promaaa/vision-sobang/sim/rl/runs/off_ss_stage1/sim2sim.md

| Model | Test | Official: result | Official: vx / yaw rate | Ours: result | Ours: vx / yaw rate |
|---|---|---|---|---|---|
| bhl_A_real | stand | no fall | +0.00 / -0.00 | no fall | +0.00 / -0.00 |
| bhl_A_real | vx 0.1 | no fall | +0.00 / -0.00 | no fall | -0.00 / -0.00 |
| bhl_A_real | vx 0.25 | no fall | +0.23 / -0.05 | no fall | -0.00 / +0.00 |
| bhl_A_real | turn on the spot 0.5 | no fall | +0.00 / +0.04 | no fall | -0.00 / +0.01 |
| bhl_A_real | vx 0.25 + yaw 0.5 | no fall | +0.23 / +0.48 | no fall | -0.00 / +0.01 |
| bhl_A_real | push test, stand | falls in 7 of 10 runs | - | falls in 10 of 10 runs | - |
| bhl_A_real | push test, vx 0.25 | falls in 5 of 10 runs | - | falls in 6 of 10 runs | - |
| bhl_A_real | push test, turn on the spot 0.5 | falls in 6 of 10 runs | - | falls in 9 of 10 runs | - |
| bhl_B_real | stand | no fall | +0.00 / -0.00 | falls at 1.1 s | - |
| bhl_B_real | vx 0.1 | no fall | +0.00 / -0.00 | falls at 3.1 s | - |
| bhl_B_real | vx 0.25 | no fall | +0.11 / -0.04 | no fall | -0.00 / -0.00 |
| bhl_B_real | turn on the spot 0.5 | no fall | +0.00 / +0.01 | falls at 1.2 s | - |
| bhl_B_real | vx 0.25 + yaw 0.5 | no fall | +0.14 / +0.46 | no fall | -0.00 / +0.01 |
| bhl_B_real | push test, stand | falls in 10 of 10 runs | - | falls in 10 of 10 runs | - |
| bhl_B_real | push test, vx 0.25 | falls in 7 of 10 runs | - | falls in 8 of 10 runs | - |
| bhl_B_real | push test, turn on the spot 0.5 | falls in 9 of 10 runs | - | falls in 10 of 10 runs | - |
