promaaa/vision-sobang/cad/backpack/renders/front.png

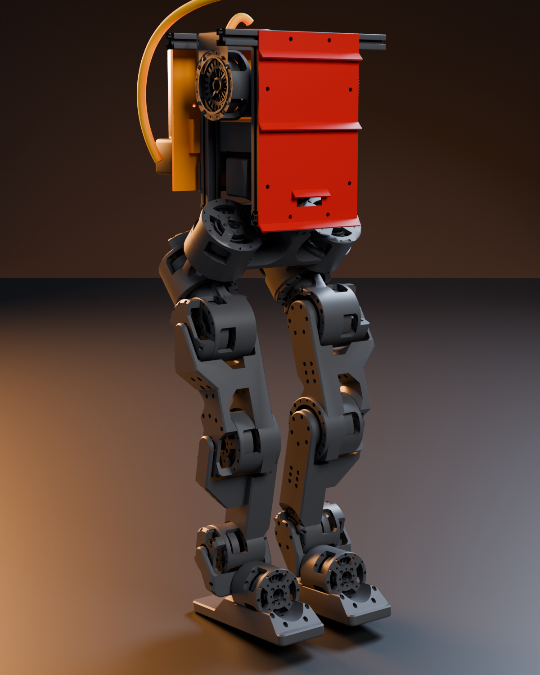
cad/backpack/renders/front.png
