promaaa/vision-sobang/cad/backpack/renders/rear.png

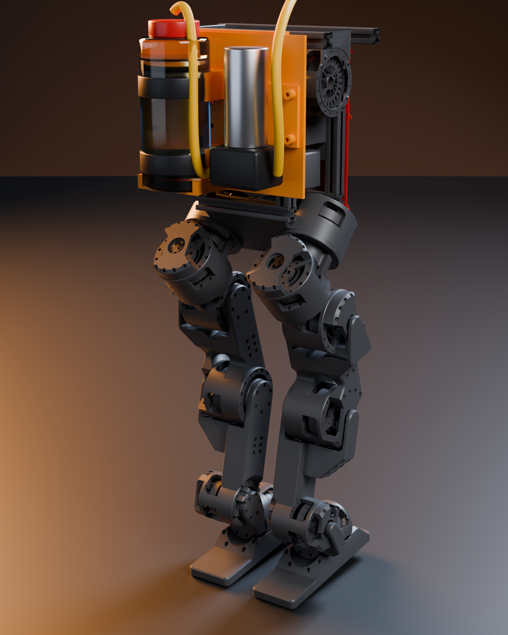
cad/backpack/renders/rear.png
