promaaa/vision-sobang/cad/backpack/renders/rear_detail.png

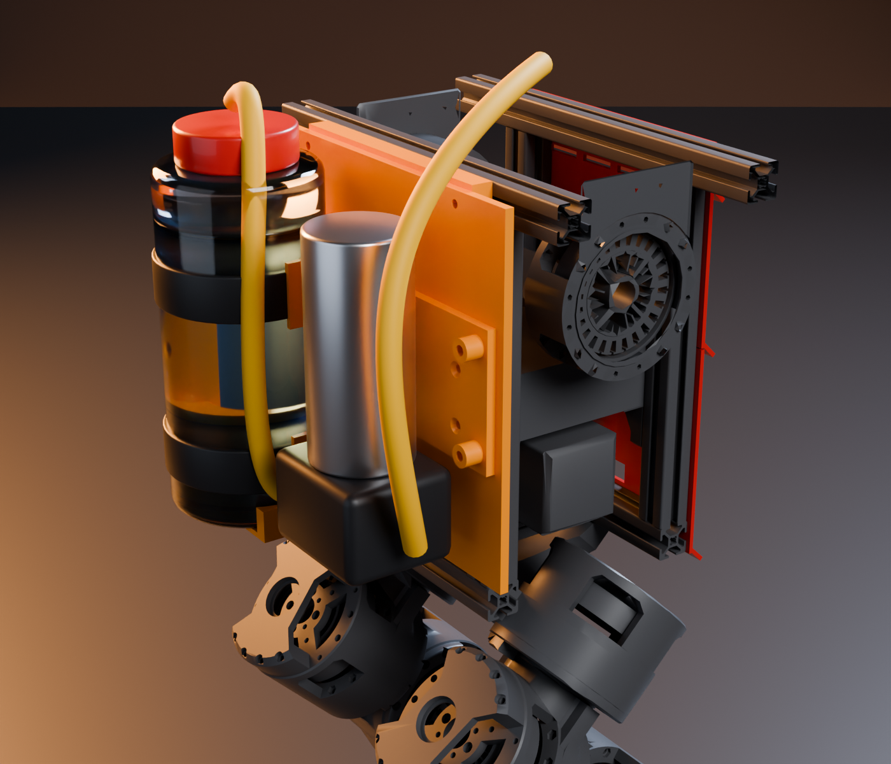
cad/backpack/renders/rear_detail.png
