promaaa/vision-sobang/cad/camera_views/out/overview_A.jpg

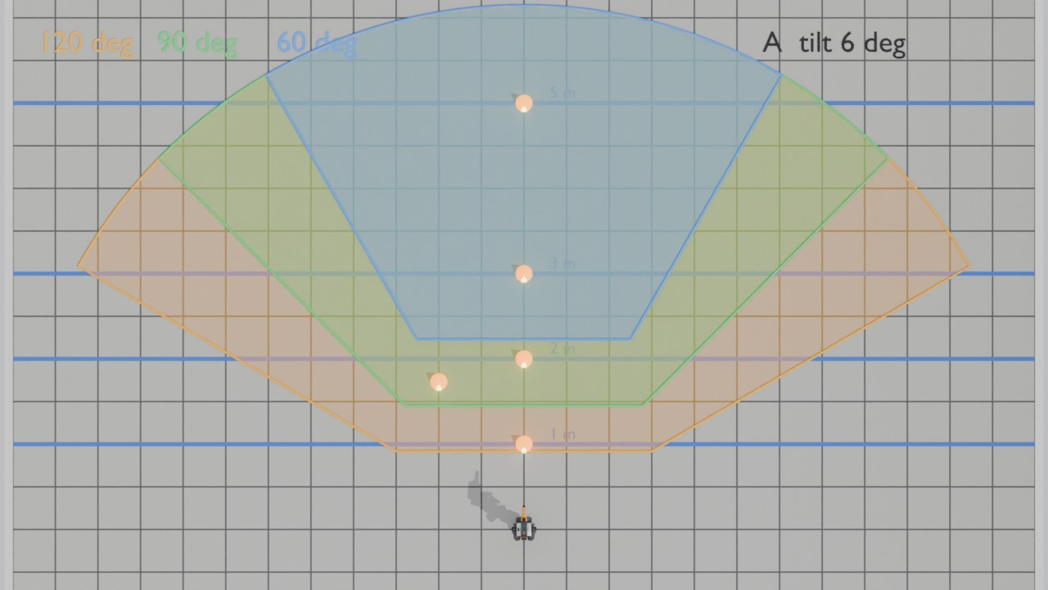
cad/camera_views/out/overview_A.jpg
