promaaa/vision-sobang/cad/camera_views/out/round2/A_1_before.jpg

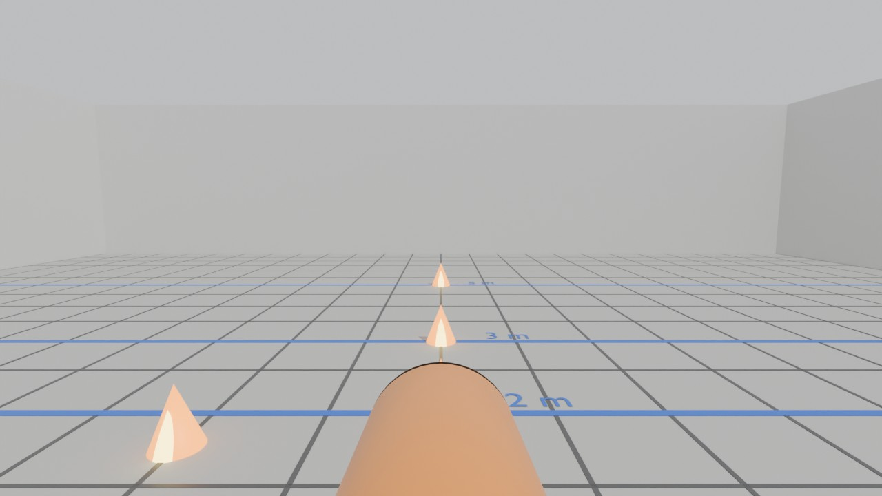
cad/camera_views/out/round2/A_1_before.jpg
