promaaa/vision-sobang/cad/camera_views/out/round2/A_2_after_camera.jpg

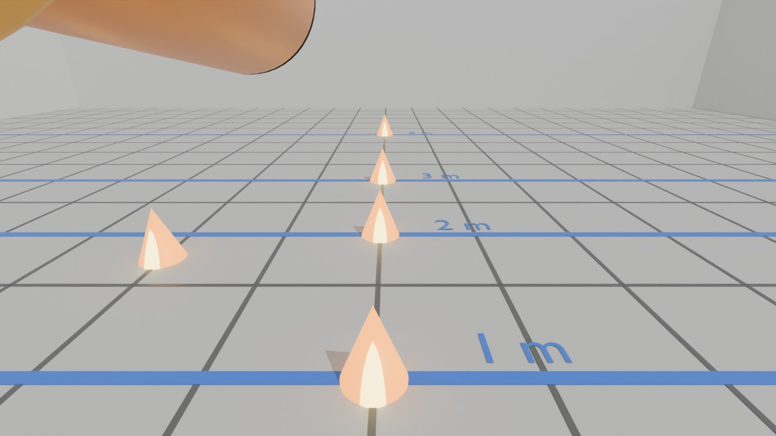
cad/camera_views/out/round2/A_2_after_camera.jpg
