promaaa/vision-sobang/cad/camera_views/out/round2/B_1_before.jpg

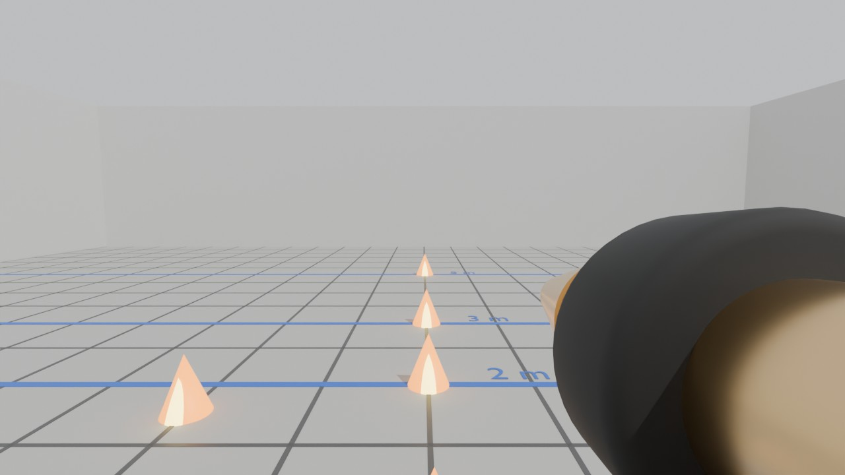
cad/camera_views/out/round2/B_1_before.jpg
