promaaa/vision-sobang/cad/camera_views/out/round2/B_3_after_nozzle.jpg

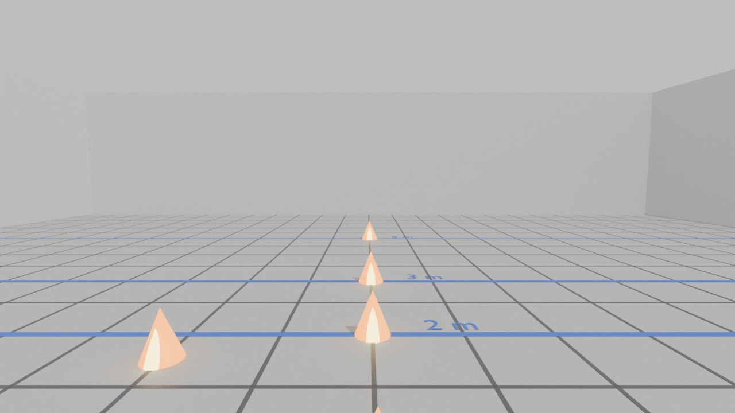
cad/camera_views/out/round2/B_3_after_nozzle.jpg
