promaaa/vision-sobang/cad/camera_views/out/views/A_tilt06_hfov060.jpg

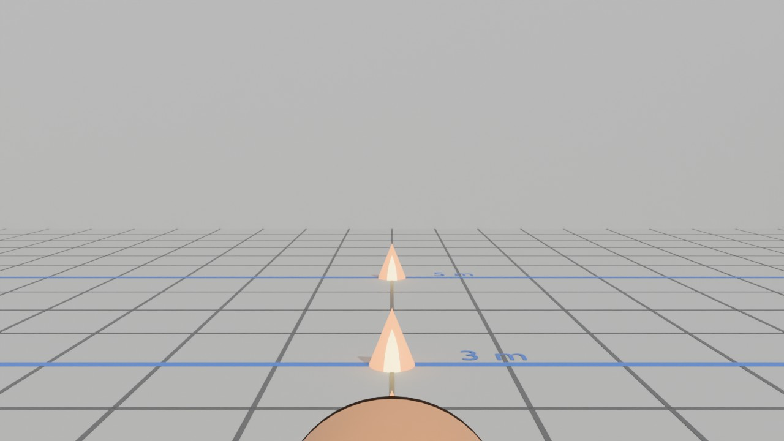
cad/camera_views/out/views/A_tilt06_hfov060.jpg
