promaaa/vision-sobang/cad/camera_views/out/views/A_tilt20_hfov060.jpg

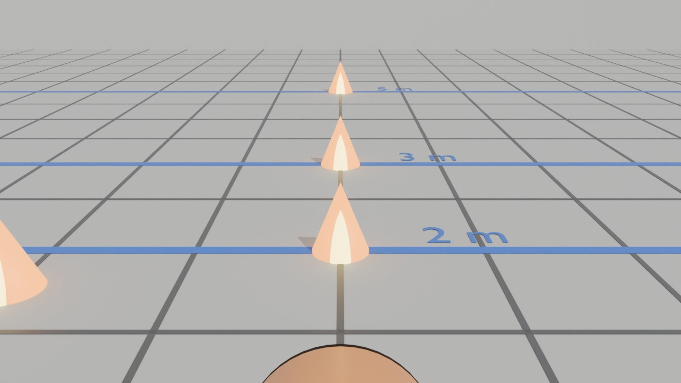
cad/camera_views/out/views/A_tilt20_hfov060.jpg
