promaaa/vision-sobang/cad/camera_views/out/views/B_tilt05_hfov120.jpg

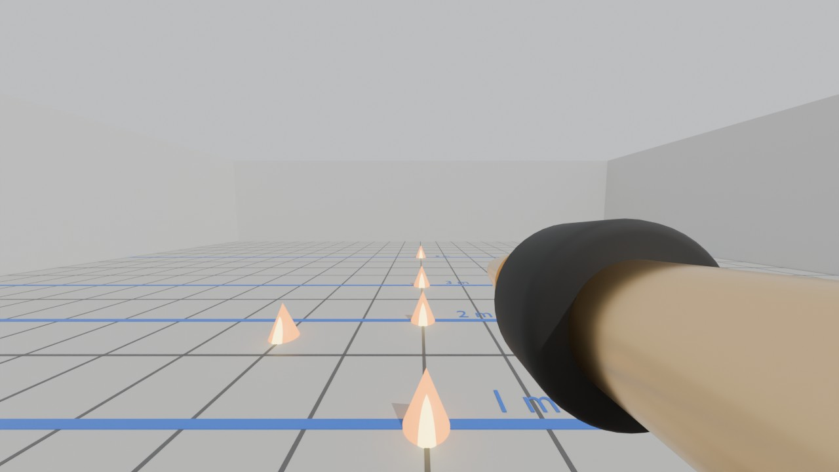
cad/camera_views/out/views/B_tilt05_hfov120.jpg
