promaaa/vision-sobang/cad/camera_views/out/views/B_tilt20_hfov120.jpg

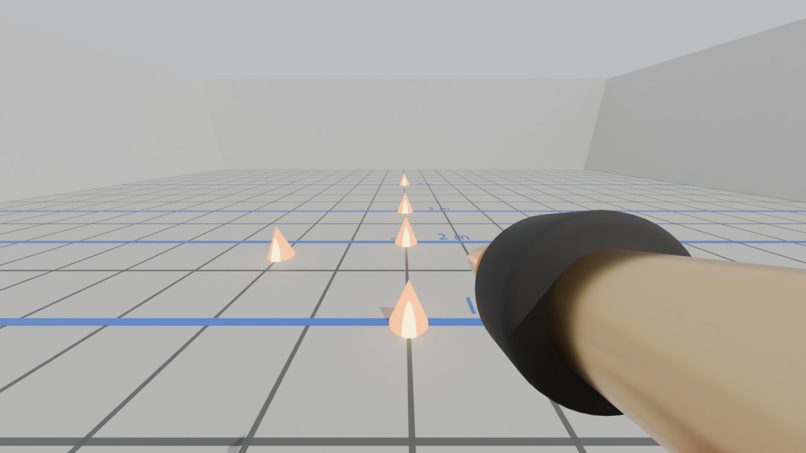
cad/camera_views/out/views/B_tilt20_hfov120.jpg
