promaaa/vision-sobang/cad/camera_views/out/views/C_tilt00_hfov060.jpg

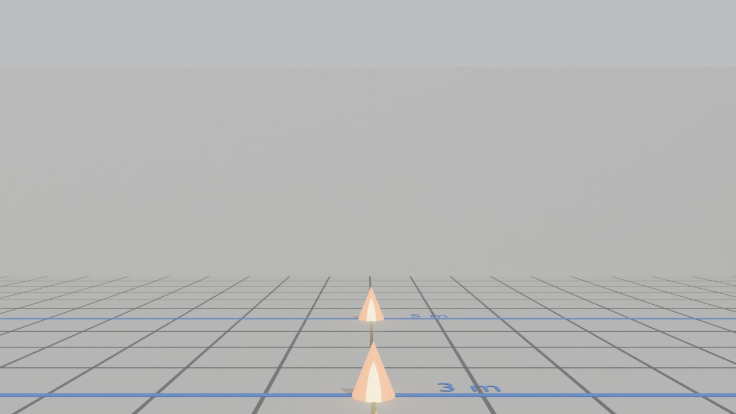
cad/camera_views/out/views/C_tilt00_hfov060.jpg
