promaaa/vision-sobang/cad/camera_views/out/views/C_tilt00_hfov120.jpg

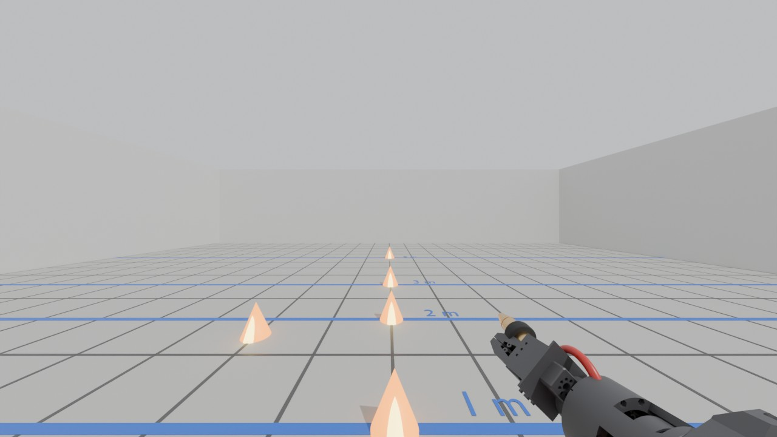
cad/camera_views/out/views/C_tilt00_hfov120.jpg
