promaaa/vision-sobang/cad/camera_views/out/views/D_tilt00_hfov090.jpg

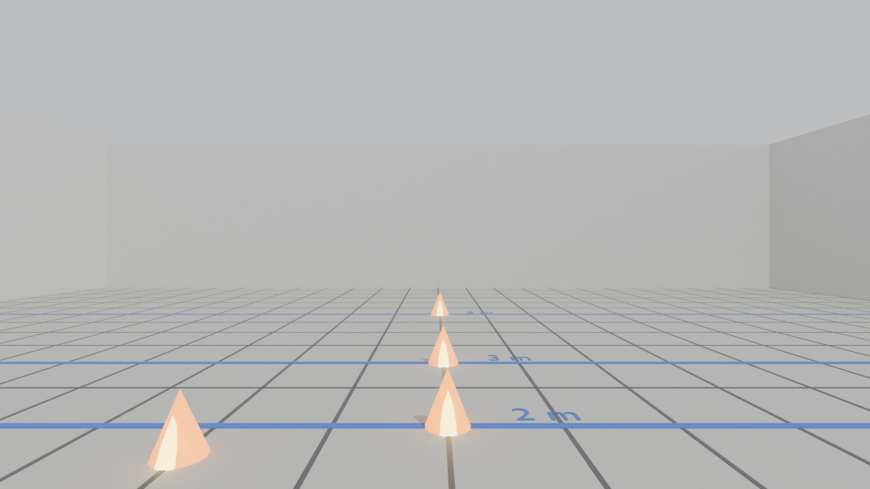
cad/camera_views/out/views/D_tilt00_hfov090.jpg
