promaaa/vision-sobang/cad/renders/concept_A_detail.jpg

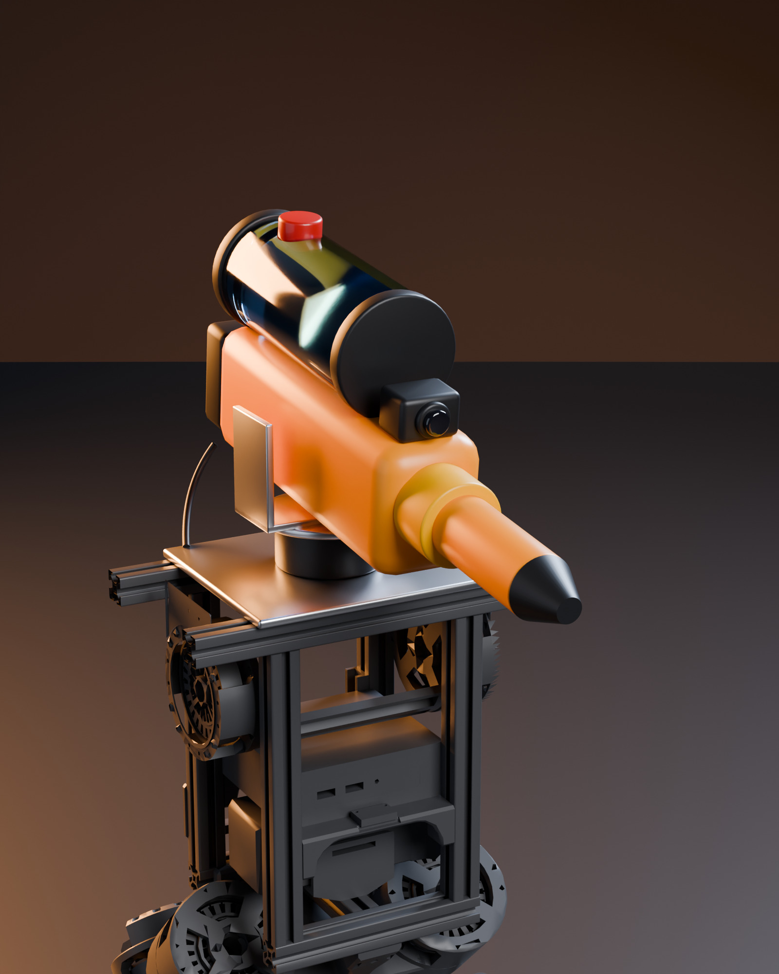
cad/renders/concept_A_detail.jpg
