promaaa/vision-sobang/cad/renders/concept_A_front.jpg

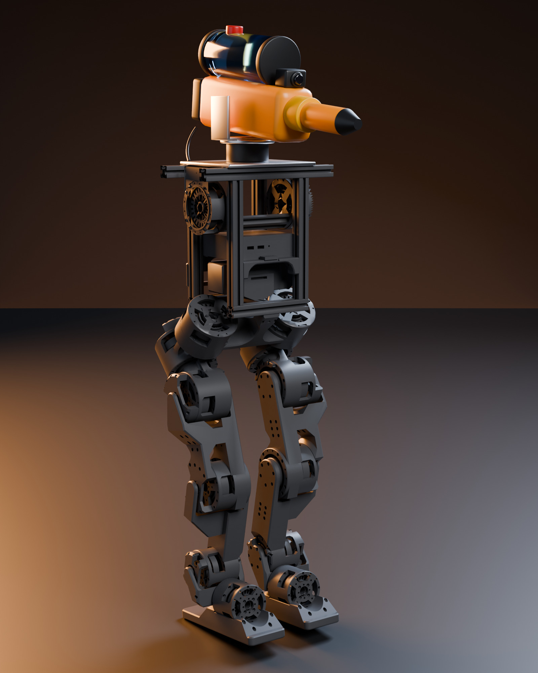
cad/renders/concept_A_front.jpg
