promaaa/vision-sobang/cad/renders/concept_A_rear.jpg

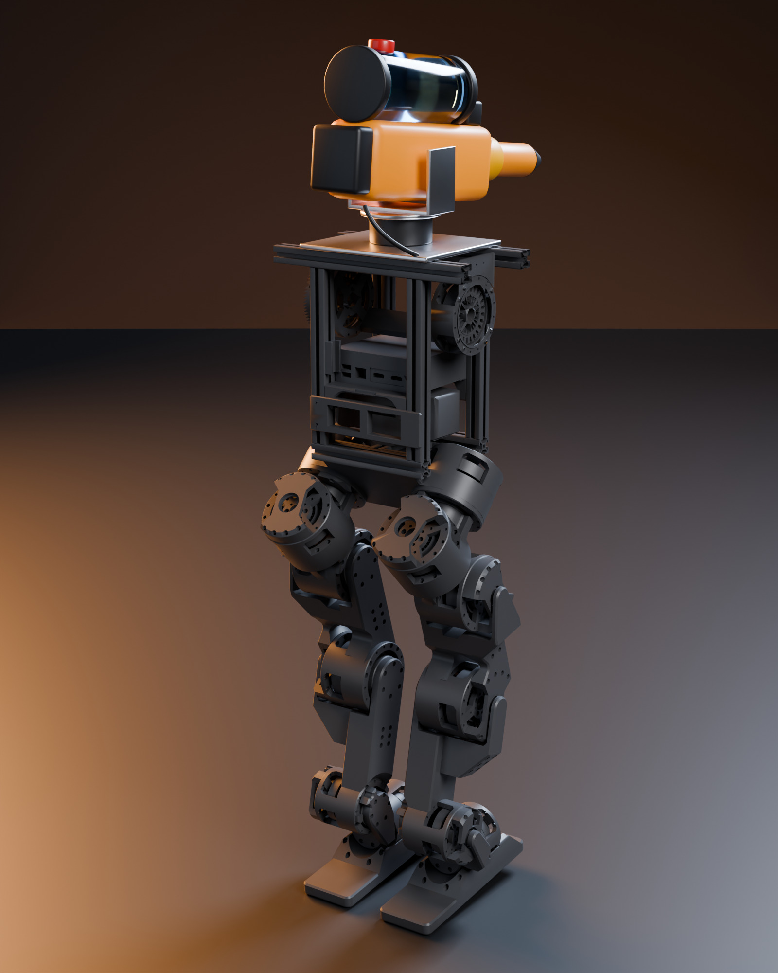
cad/renders/concept_A_rear.jpg
