promaaa/vision-sobang/cad/renders/concept_B_detail.jpg

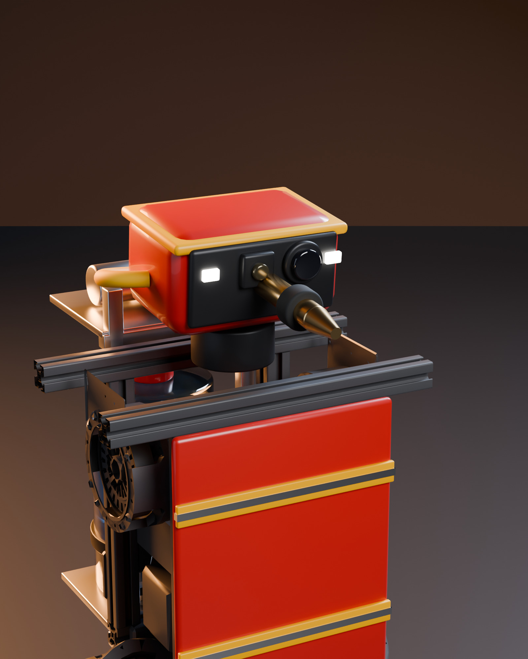
cad/renders/concept_B_detail.jpg
