promaaa/vision-sobang/cad/renders/concept_B_front.jpg

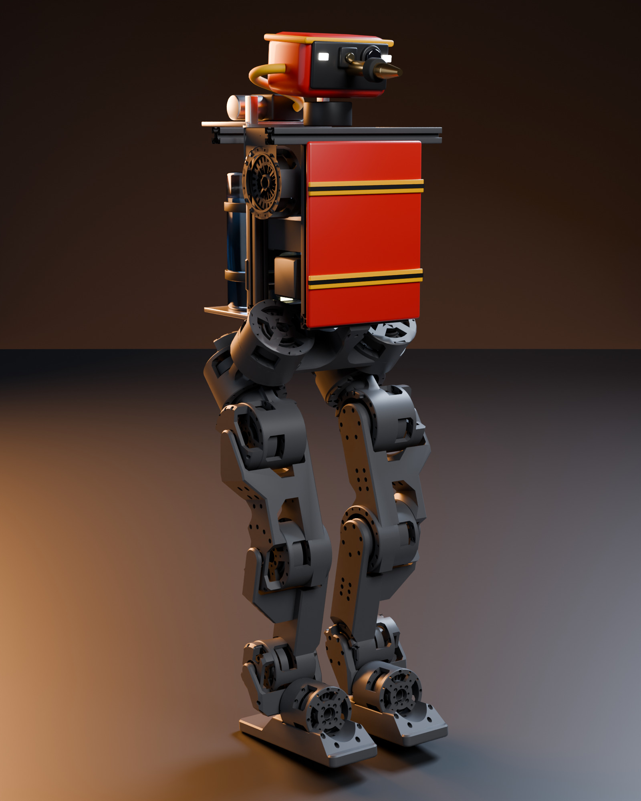
cad/renders/concept_B_front.jpg
