promaaa/vision-sobang/cad/renders/concept_B_rear.jpg

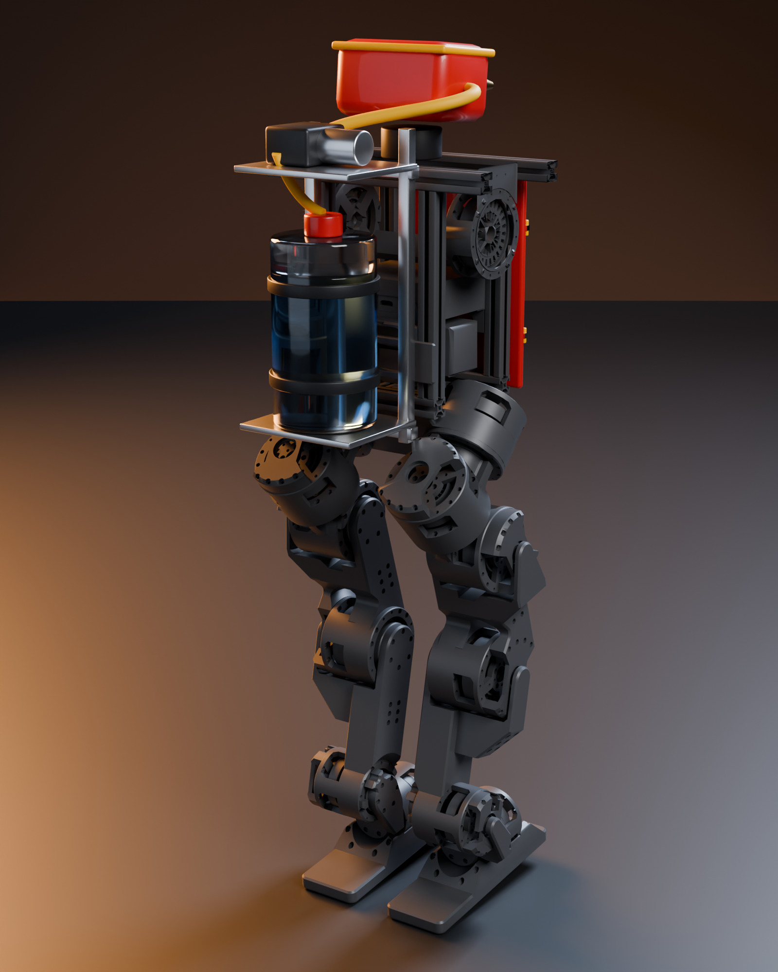
cad/renders/concept_B_rear.jpg
