promaaa/vision-sobang/cad/renders/concept_C_detail.jpg

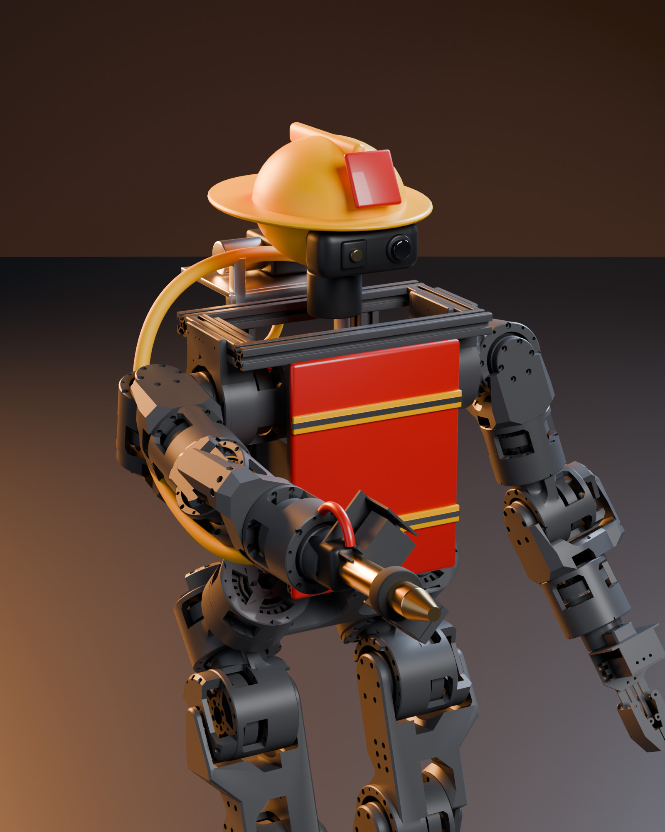
cad/renders/concept_C_detail.jpg
