promaaa/vision-sobang/cad/renders/concept_C_front.jpg

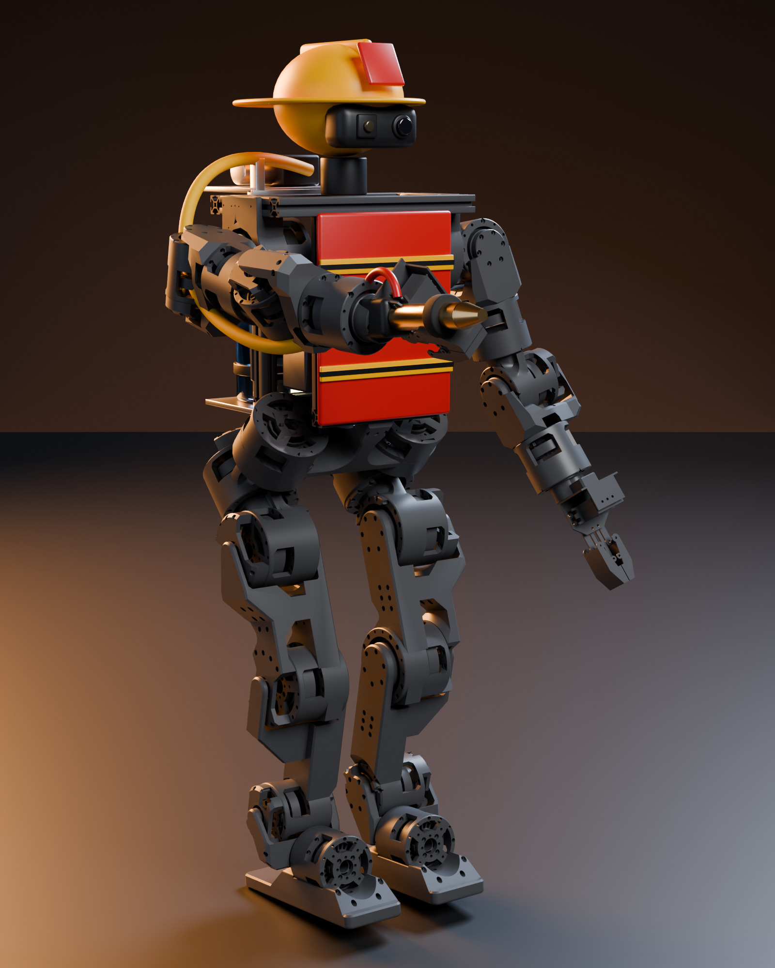
cad/renders/concept_C_front.jpg
