promaaa/vision-sobang/cad/renders/concept_C_rear.jpg

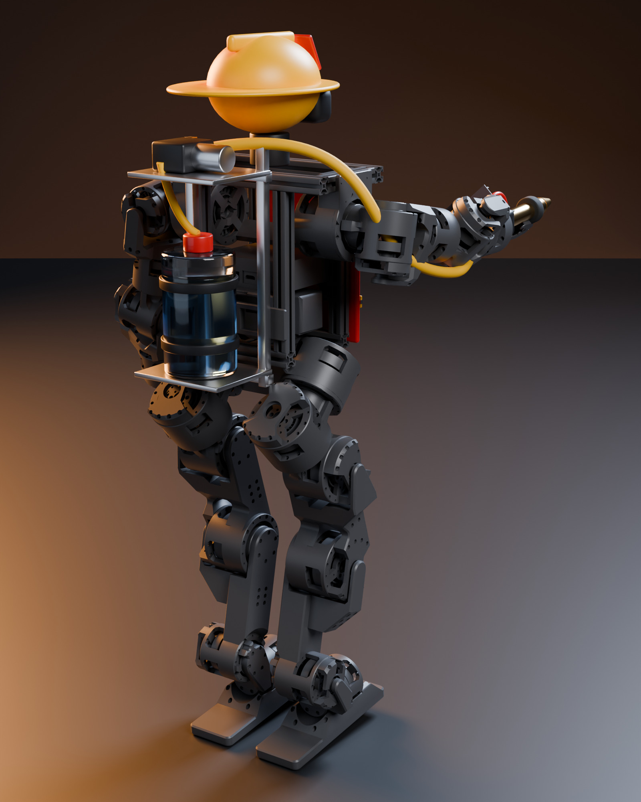
cad/renders/concept_C_rear.jpg
