promaaa/vision-sobang/cad/renders/concept_D_detail.jpg

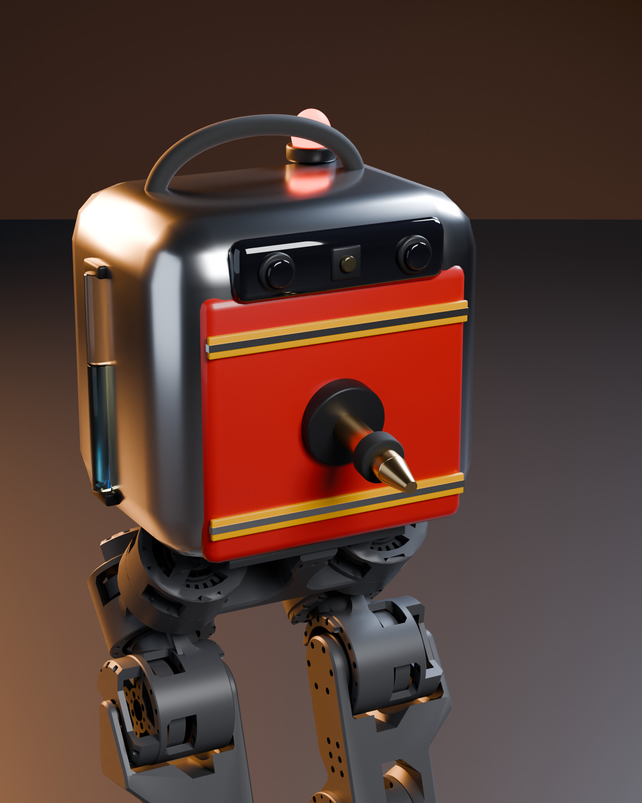
cad/renders/concept_D_detail.jpg
