promaaa/vision-sobang/cad/renders/concept_D_front.jpg

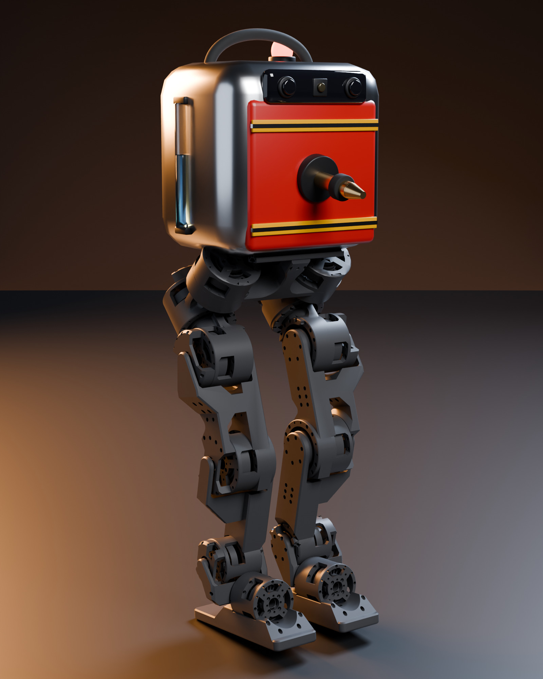
cad/renders/concept_D_front.jpg
