promaaa/vision-sobang/cad/renders/concept_D_rear.jpg

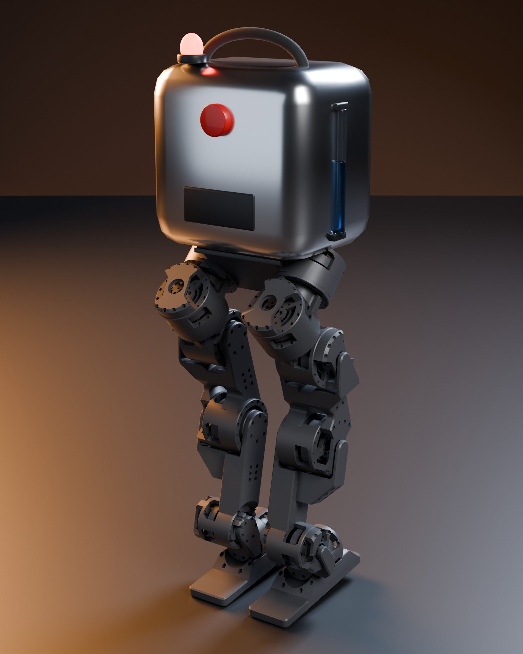
cad/renders/concept_D_rear.jpg
