promaaa/vision-sobang/cad/renders/concept_E_detail.jpg

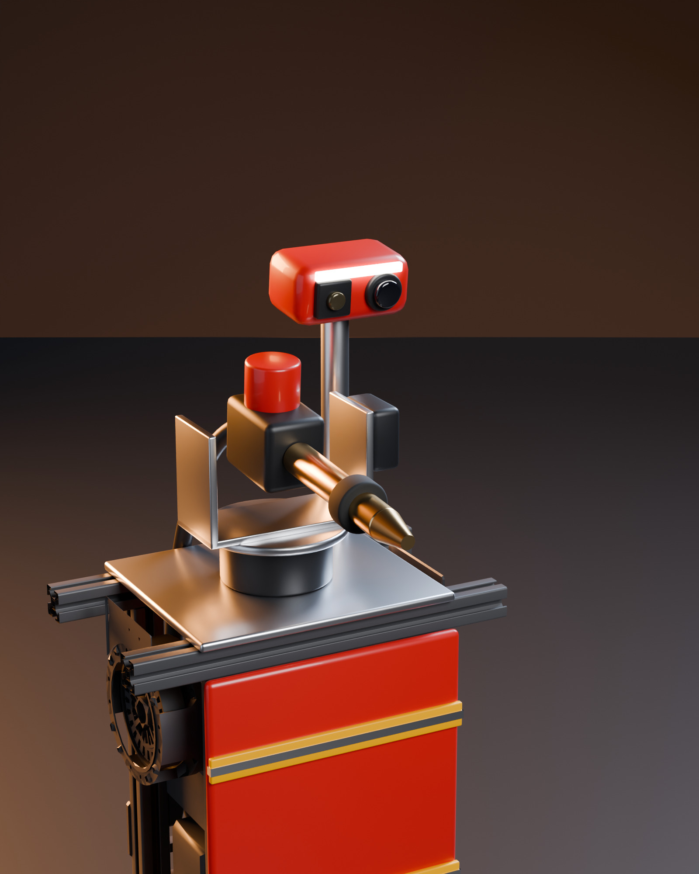
cad/renders/concept_E_detail.jpg
