promaaa/vision-sobang/cad/renders/concept_E_front.jpg

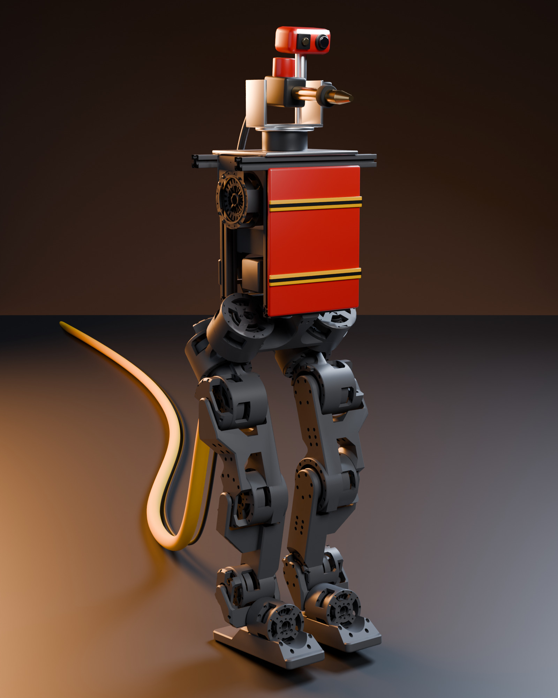
cad/renders/concept_E_front.jpg
