promaaa/vision-sobang/cad/renders/concept_E_rear.jpg

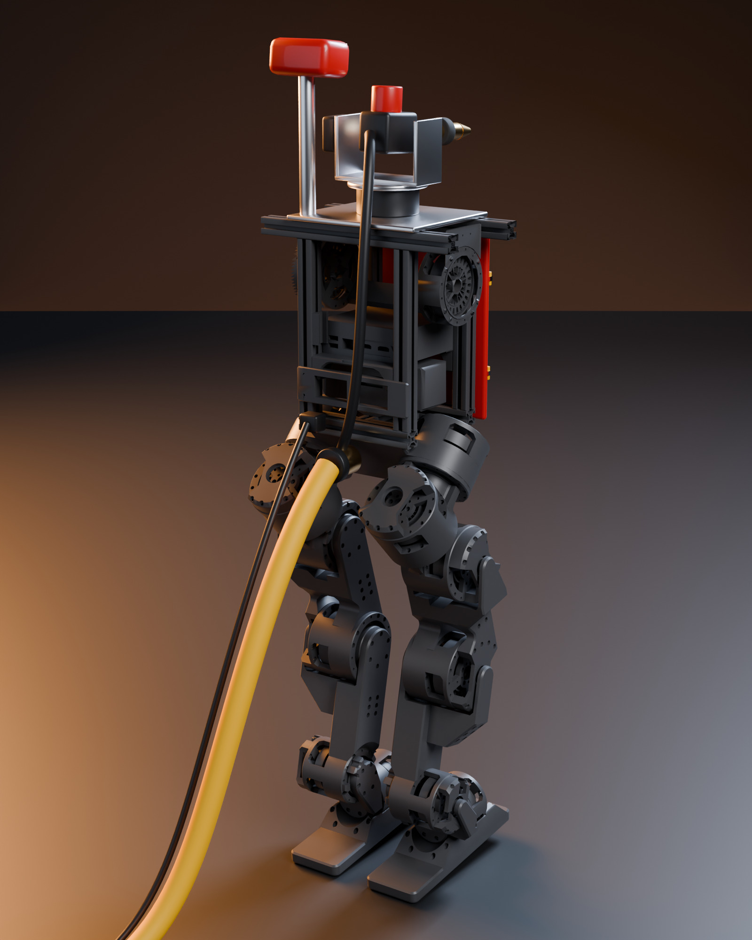
cad/renders/concept_E_rear.jpg
