promaaa/vision-sobang/cad/renders/lineup.jpg

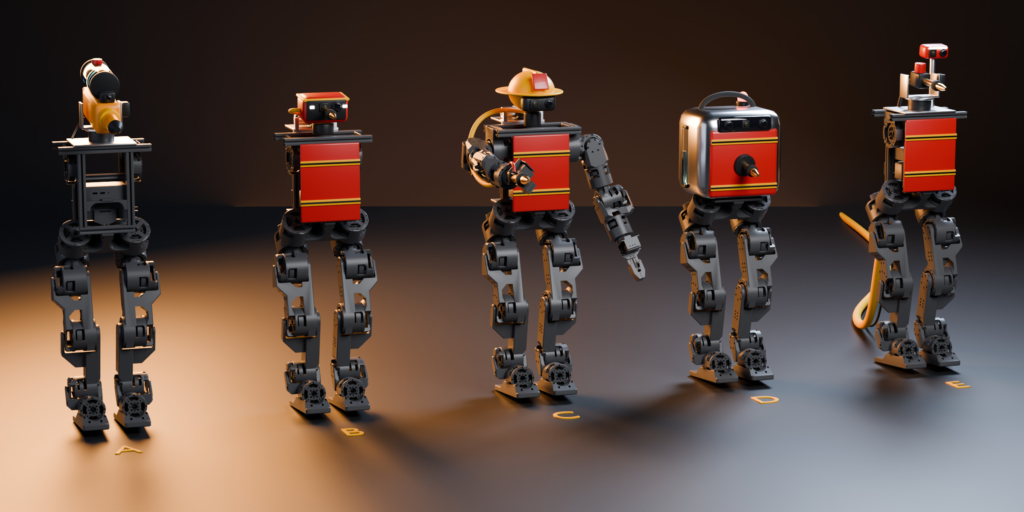
cad/renders/lineup.jpg
