promaaa/vision-sobang/cad/torso_tank/renders/r1_cutaway.jpg

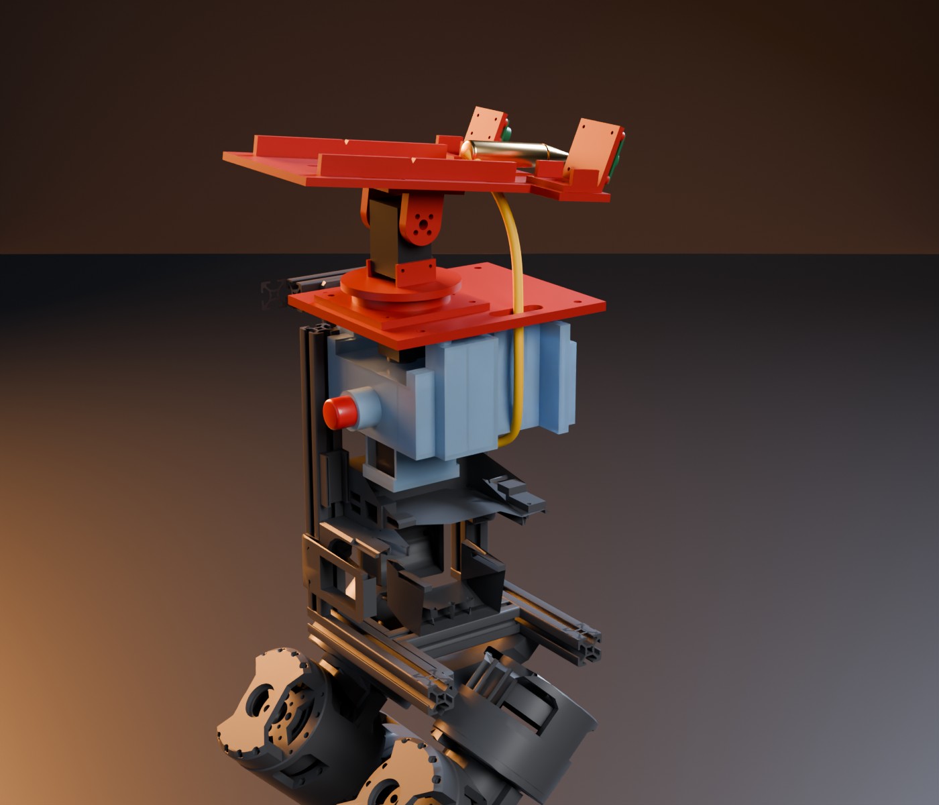
cad/torso_tank/renders/r1_cutaway.jpg
