promaaa/vision-sobang/cad/torso_tank/renders/r1_exploded.jpg

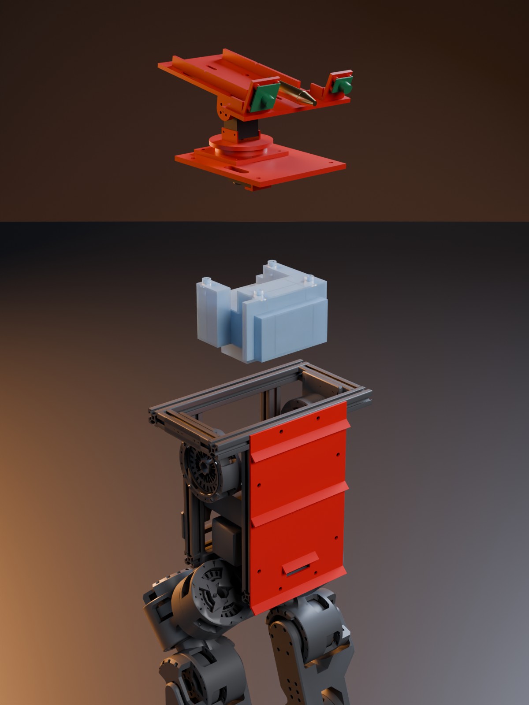
cad/torso_tank/renders/r1_exploded.jpg
