promaaa/vision-sobang/cad/torso_tank/renders/r2_detail.jpg

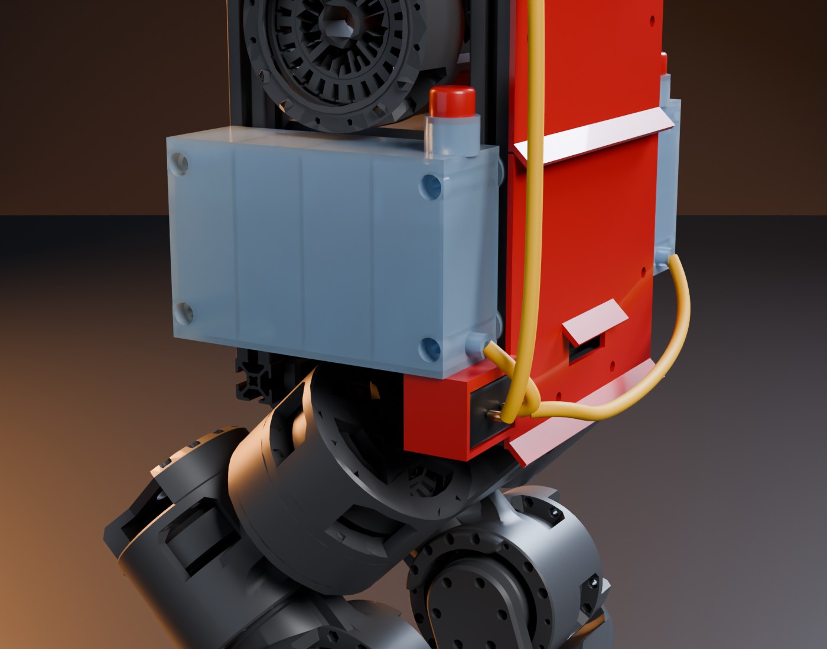
cad/torso_tank/renders/r2_detail.jpg
