promaaa/vision-sobang/cad/torso_tank/renders/r2_front.jpg

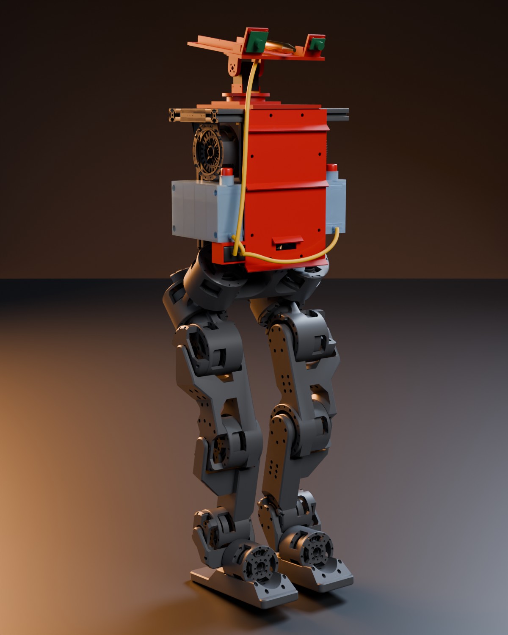
cad/torso_tank/renders/r2_front.jpg
