promaaa/vision-sobang/cad/torso_tank/renders/r2_rear.jpg

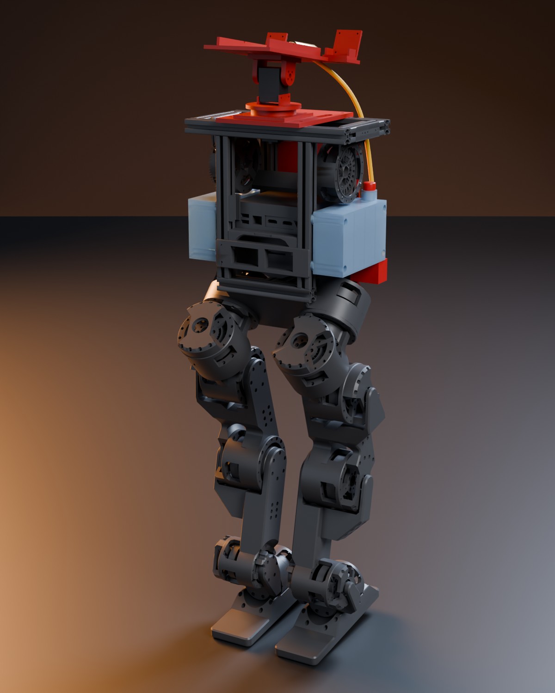
cad/torso_tank/renders/r2_rear.jpg
