promaaa/vision-sobang/cad/torso_tank/renders/turntable_r1.jpg

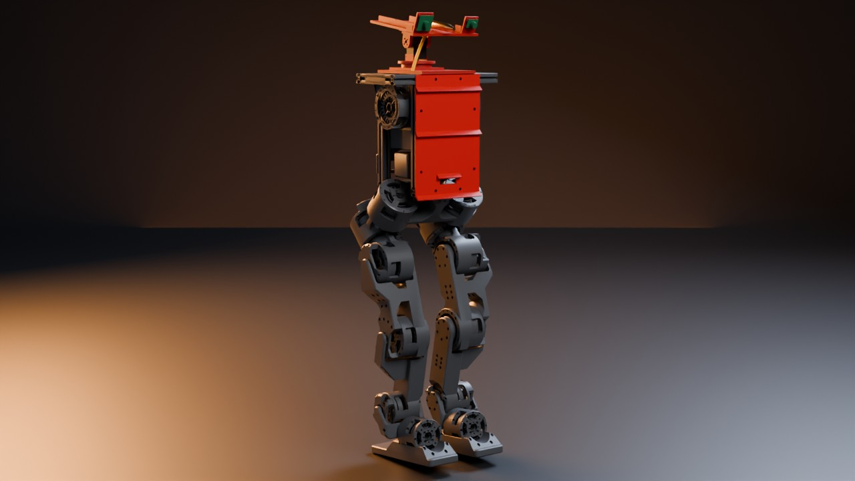
cad/torso_tank/renders/turntable_r1.jpg
