promaaa/vision-sobang/cad/turntable/bench_turntable.jpg

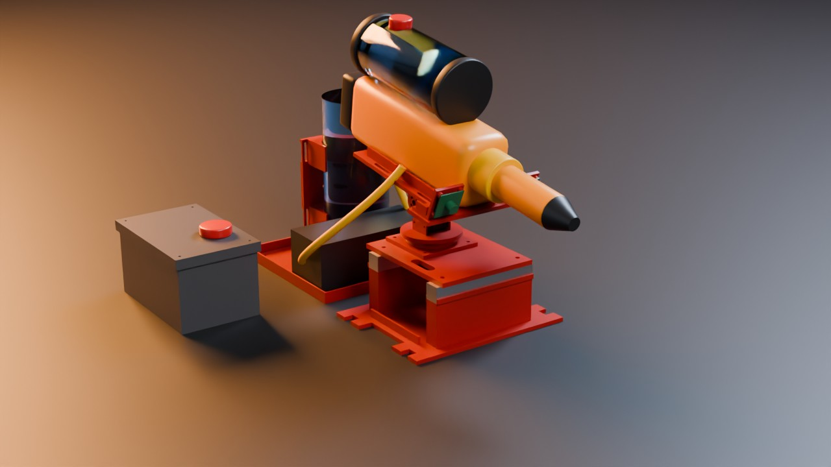
cad/turntable/bench_turntable.jpg
