promaaa/vision-sobang/sim/payload/results/torso_push_B_real_poster.jpg

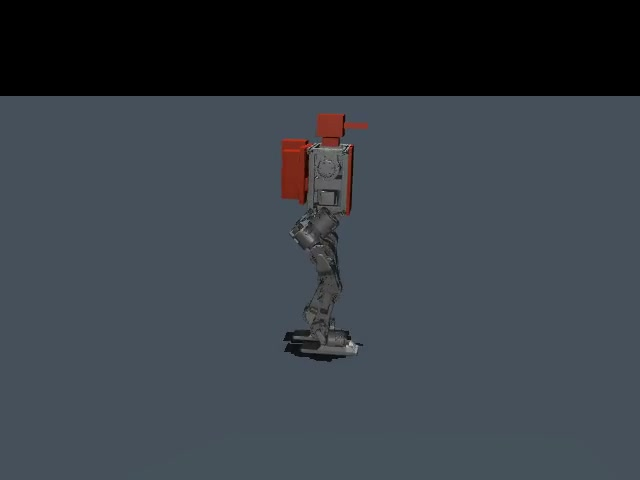
sim/payload/results/torso_push_B_real_poster.jpg
