promaaa/vision-sobang/sim/payload/results/torso_push_R2_poster.jpg

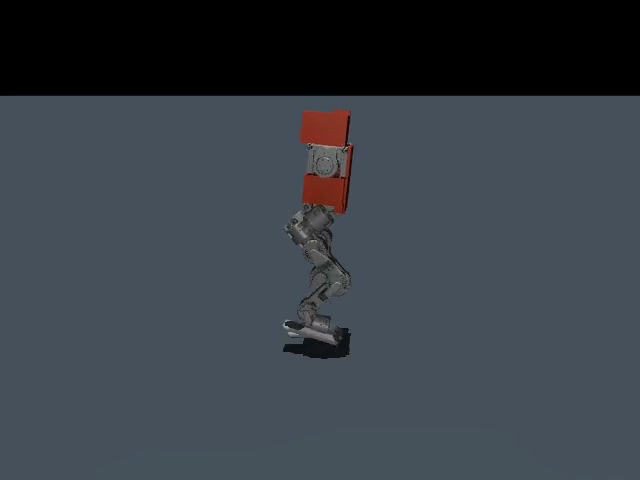
sim/payload/results/torso_push_R2_poster.jpg
