promaaa/vision-sobang/sim/payload/results/torso_R2_walk_poster.jpg

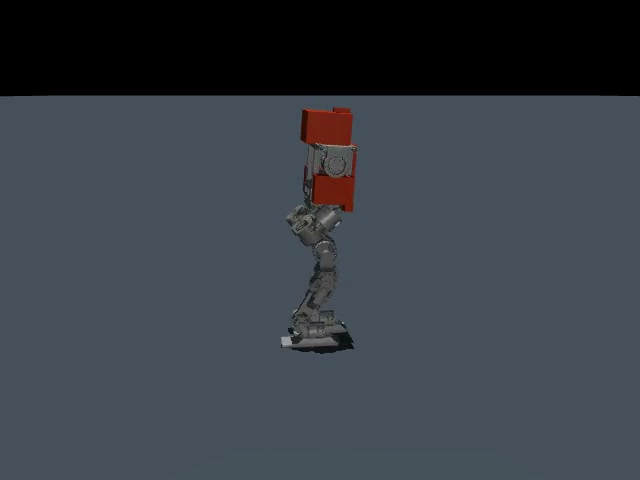
sim/payload/results/torso_R2_walk_poster.jpg
