promaaa/vision-sobang/sim/payload/results/torso_slosh_R1_poster.jpg

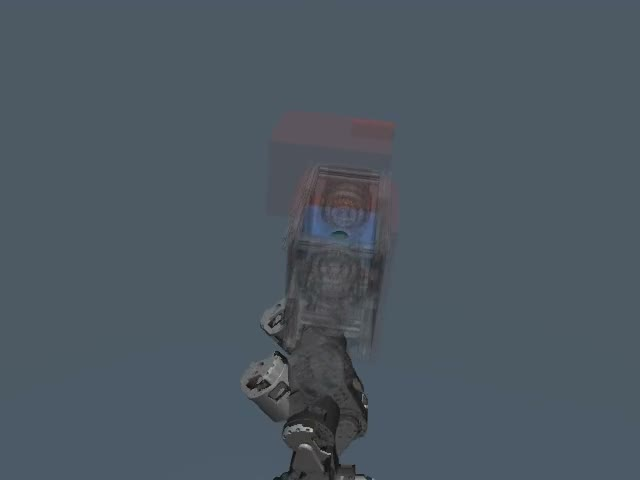
sim/payload/results/torso_slosh_R1_poster.jpg
