promaaa/vision-sobang/sim/rl/runs/a05_nm6/reward_curve.png

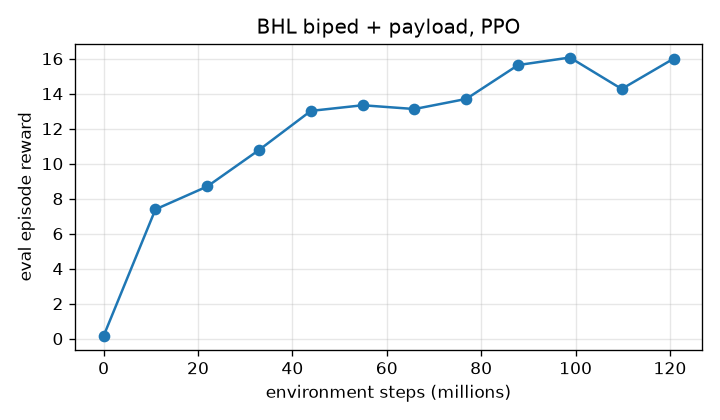
sim/rl/runs/a05_nm6/reward_curve.png
