promaaa/vision-sobang/sim/rl/runs/a05_nm6_p35_knee14/reward_curve.png

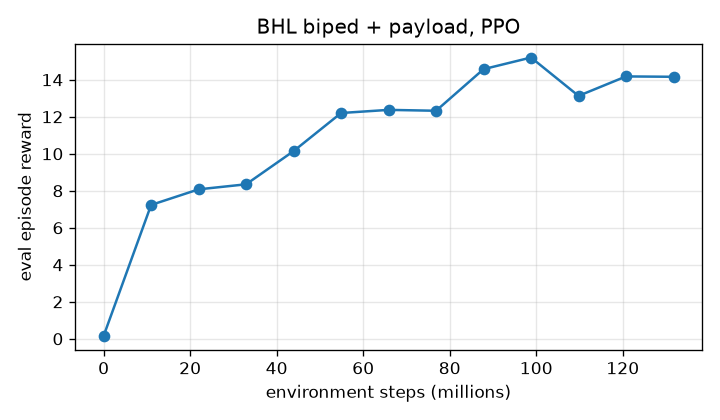
sim/rl/runs/a05_nm6_p35_knee14/reward_curve.png
