promaaa/vision-sobang/sim/rl/runs/a05_nm20/reward_curve.png

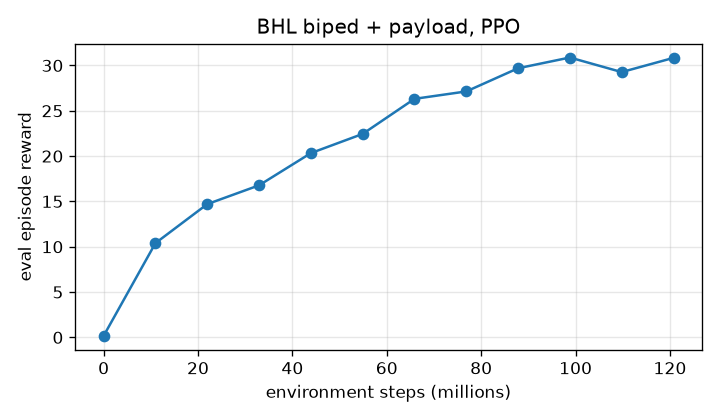
sim/rl/runs/a05_nm20/reward_curve.png
