promaaa/vision-sobang/sim/rl/runs/reward_curves.png

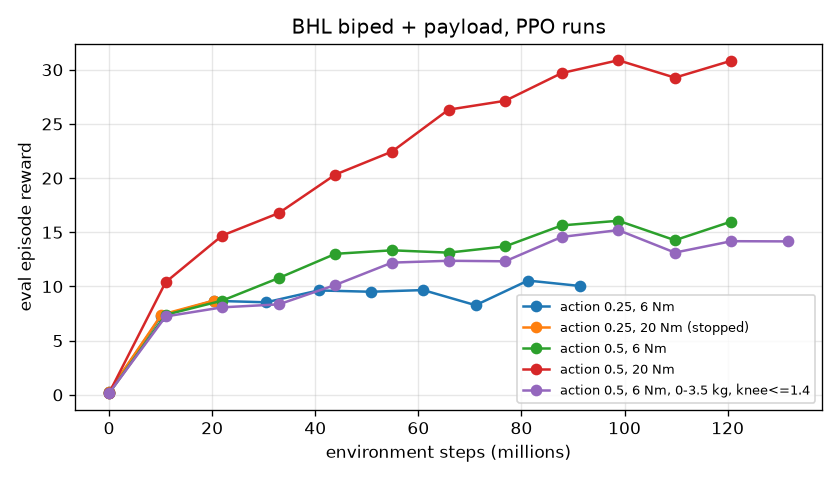
sim/rl/runs/reward_curves.png
