promaaa/vision-sobang/docs/hardware/bom_A.csv

item | qty | unit_price_krw_or_usd | currency | link | accessed | notes
Serial bus servo Waveshare ST3215 (Feetech STS3215) 12 V version, pan and tilt | 2 | 21.99 | USD | https://www.waveshare.com/st3215-servo.htm?sku=22414 | 2026-10-08 | 6-12.6 V; 30 kg.cm at 12 V; stall 2.7 A; position/load/speed/voltage feedback; 12 V version is SKU 22414 at USD 21.99 (7.4 V version is USD 16.99); Korean shop for 12 V version not found
Waveshare Bus Servo Adapter (A), USB to servo bus | 1 | 4.99 | USD | https://www.waveshare.com/bus-servo-adapter-a.htm | 2026-10-08 | input 9-12.6 V; 5.5x2.1 mm DC jack
Pan-tilt brackets | 1 |  |  |  |  | not found; plan to 3D-print in PLA like the BHL parts
DC-DC buck 12 V 10 A SZH-PWSD-064 | 1 | 14300 | KRW | https://www.devicemart.co.kr/goods/view?no=16084804 | 2026-10-08 | input 15-90 V covers 6S LiPo 18-25.2 V; IP68; feeds servos (and pump or valve in B/E)
Raspberry Pi Pico (MCU for relay switching) | 1 | 5940 | KRW | https://www.devicemart.co.kr/goods/view?no=13921792 | 2026-10-08 | USB to robot computer
2-channel 5 V relay module with optocoupler | 1 | 2310 | KRW | https://www.devicemart.co.kr/goods/view?no=1327557 | 2026-10-08 | 10 A at 30 VDC; 3.3 V trigger from Pico unverified
E-stop button KGE-N4R2R 22 mm, push-lock turn-reset, 2 NO + 2 NC | 1 | 12100 | KRW | https://www.devicemart.co.kr/goods/view?no=10895014 | 2026-10-08 | contact rating not found; switches the coil of the power relay
Power relay KKA-K4, 24 V coil, 40 A (switched by the e-stop) | 1 | 7150 | KRW | https://www.devicemart.co.kr/goods/view?no=14822397 | 2026-10-08 | carries the add-on 24 V current
ATO blade fuse holder 287 | 1 | 2420 | KRW | https://www.devicemart.co.kr/goods/view?no=12170195 | 2026-10-08 | inline type unverified
Blade fuse set 10 pcs (10/15/20/25/30 A) | 1 | 2200 | KRW | https://www.devicemart.co.kr/goods/view?no=1321122 | 2026-10-08 | use 10 A at the 24 V tap; 5 A fuse URL not found
XT30 connector pair for the BHL 24 V bus tap | 1 |  |  |  |  | not found; BHL uses XT30 taps on its main bus
XT60 connector pair | 1 | 1760 | KRW | https://www.devicemart.co.kr/goods/view?no=1078005 | 2026-10-08 | for the add-on box input
Silicone wire 16 AWG, 1 m red + 1 m black (DFRobot FIT0584) | 2 | 6930 | KRW | https://www.devicemart.co.kr/goods/view?no=16057418 | 2026-10-08 | 35 A rating per listing
Dupont F/F jumper set | 1 | 6270 | KRW | https://www.devicemart.co.kr/goods/view?no=1386062 | 2026-10-08 | signal wiring
Powered USB hub | 1 |  |  |  |  | not found; BHL USB ports are used by 4 USB-CAN adapters
Plastic enclosure IP65 for the add-on electronics | 1 |  |  |  |  | not found
Electric water gun Daiso 전동 기관단총 워터건 | 1 | 5000 | KRW | https://www.daisomall.co.kr/pd/pdr/SCR_PDR_0001?pdNo=1075502 | 2026-10-08 | about 100 mL tank; 3 x AA; range not listed; cheapest first test gun
USB RGB camera (Marc chooses, see README section 4) | 1 |  |  |  |  | excluded from total; example ELP-USBFHD01M-L180 USD 42.00
