promaaa/vision-sobang/cad/parts/renders/adapters_B_E.jpg

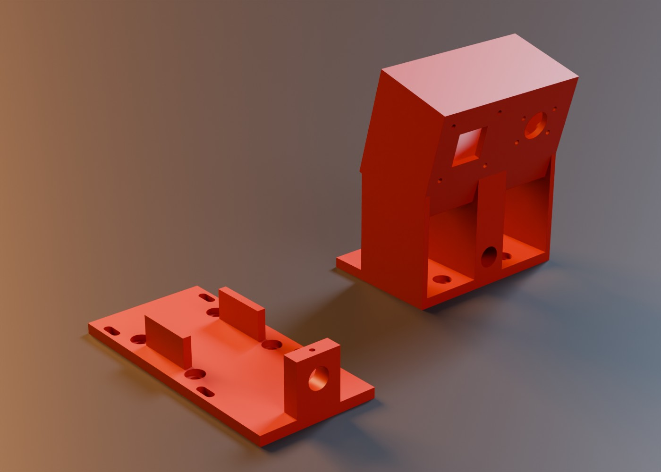
cad/parts/renders/adapters_B_E.jpg
