promaaa/vision-sobang/cad/parts/renders/module_on_robot.jpg

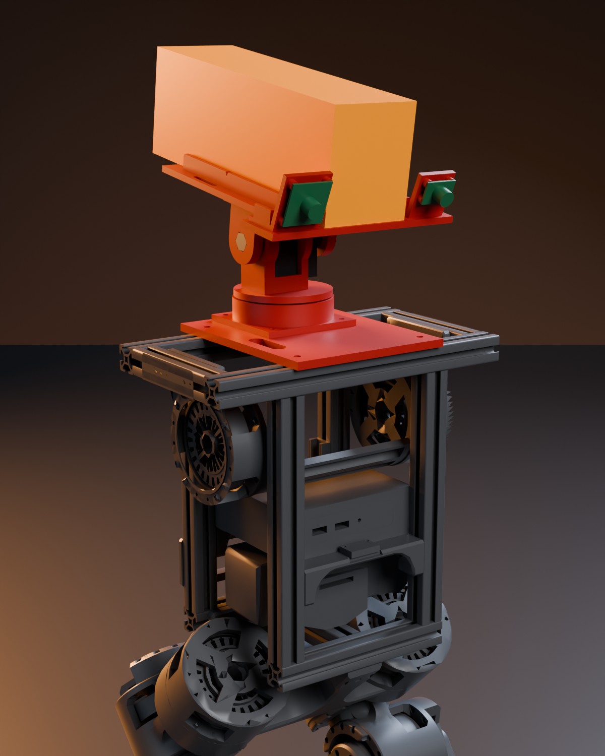
cad/parts/renders/module_on_robot.jpg
