promaaa/vision-sobang/cad/parts/renders/module_on_robot_full.jpg

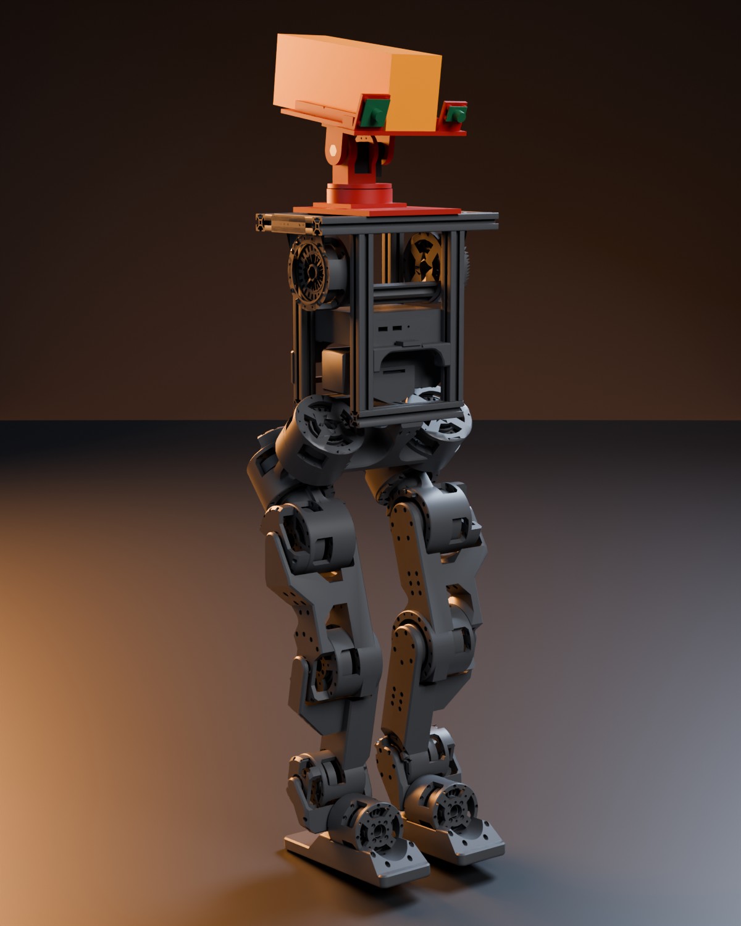
cad/parts/renders/module_on_robot_full.jpg
