promaaa/vision-sobang/cad/backpack/out/bracket_lower.step

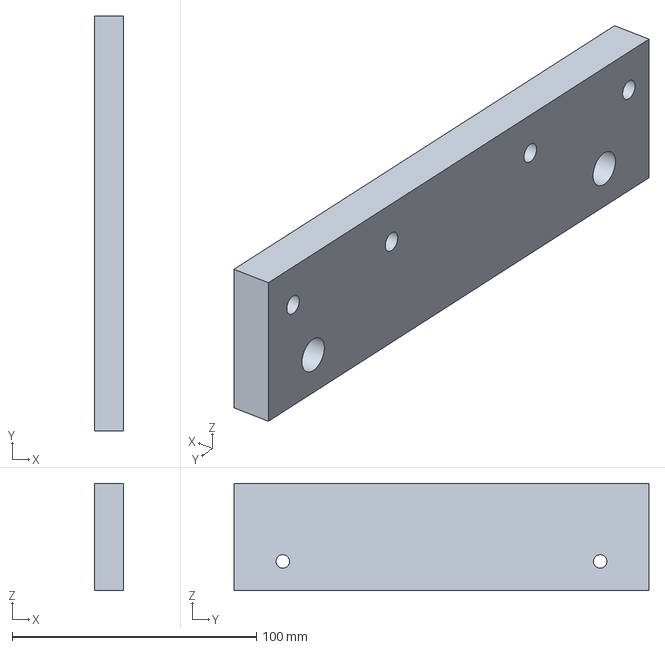
[picture p93: CAD file, 2026-10-11]
cad/backpack/out/bracket_lower.step
12.0 x 170.0 x 44.0 mm
