promaaa/vision-sobang/cad/bench/out/base_clamp.step

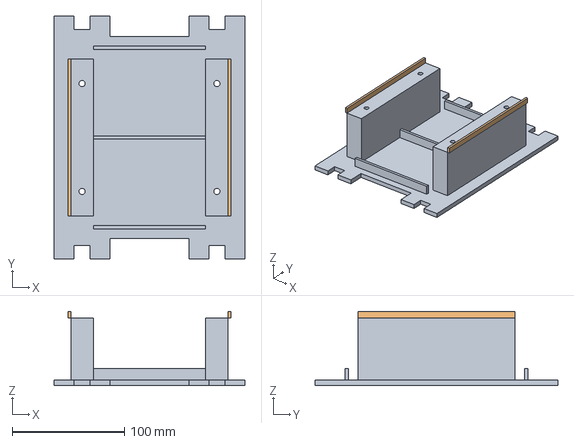
[picture p94: CAD file, 2026-10-11]
cad/bench/out/base_clamp.step
170.0 x 216.0 x 66.0 mm
