promaaa/vision-sobang/cad/bench/out/ref/ref_pump.stl

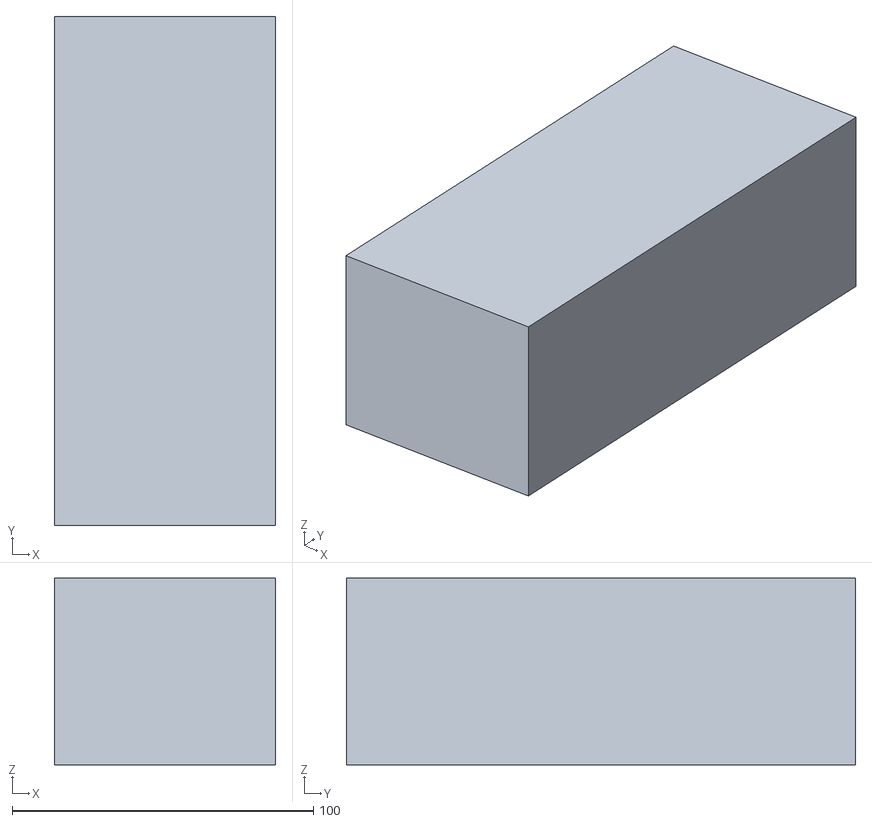
[picture p95: CAD file, 2026-10-11]
cad/bench/out/ref/ref_pump.stl
73.5 x 169.0 x 62.0
