promaaa/vision-sobang/cad/parts/out/cam_purethermal.step

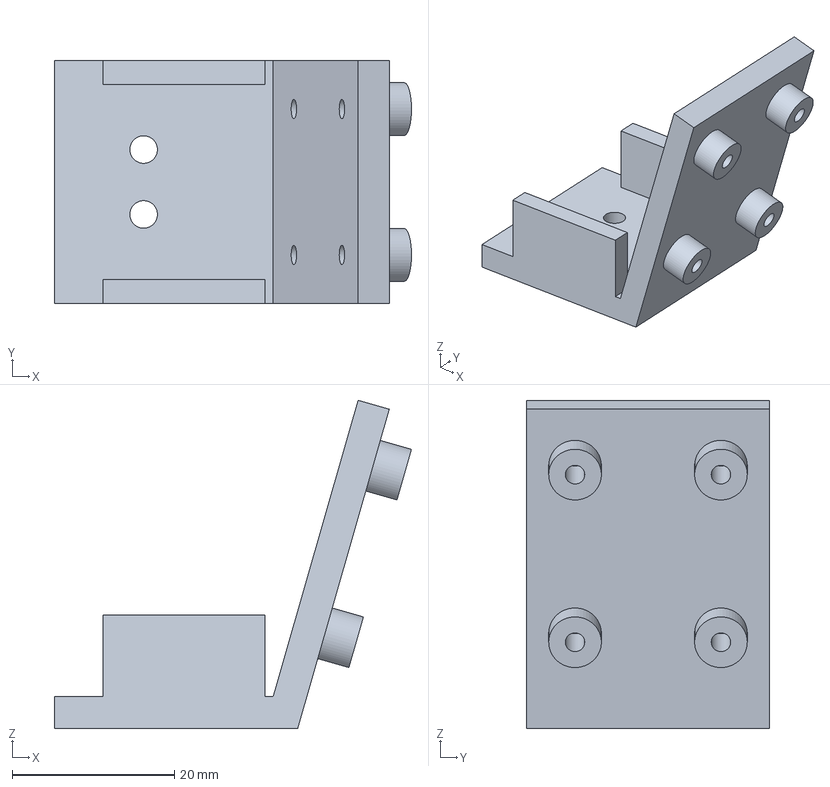
[picture p96: CAD file, 2026-10-11]
cad/parts/out/cam_purethermal.step
44.0 x 30.0 x 40.5 mm
