promaaa/vision-sobang/cad/parts/out/ref/ref_tilt_bearing.stl

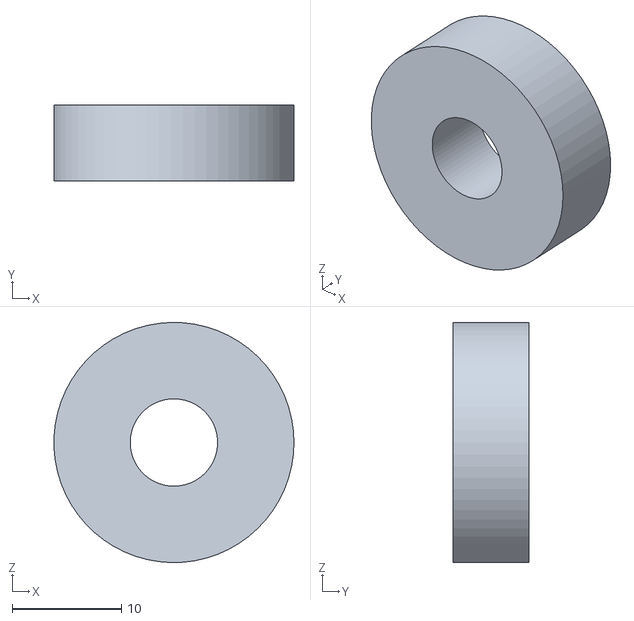
[picture p97: CAD file, 2026-10-11]
cad/parts/out/ref/ref_tilt_bearing.stl
22.0 x 7.00 x 22.0
