promaaa/vision-sobang/cad/parts/out_sts3215/cam_mlx90640.step

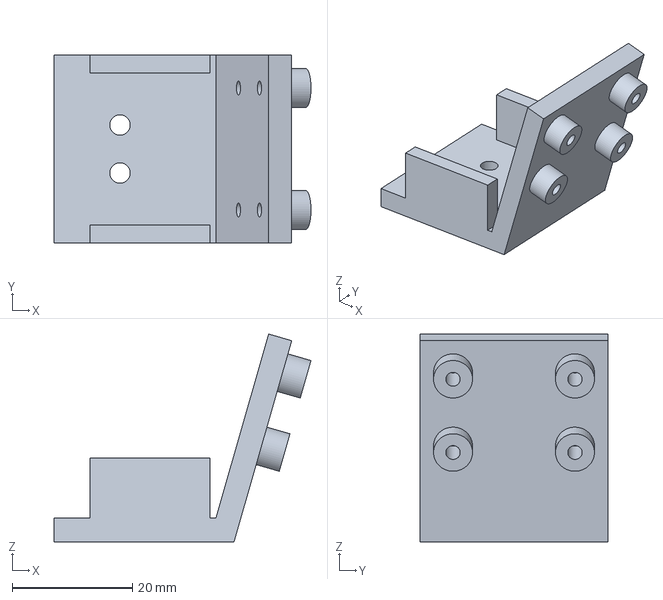
[picture p98: CAD file, 2026-10-11]
cad/parts/out_sts3215/cam_mlx90640.step
42.8 x 31.4 x 34.6 mm
