promaaa/vision-sobang/cad/parts/out_sts3215/ref/ref_pan_bearing.stl

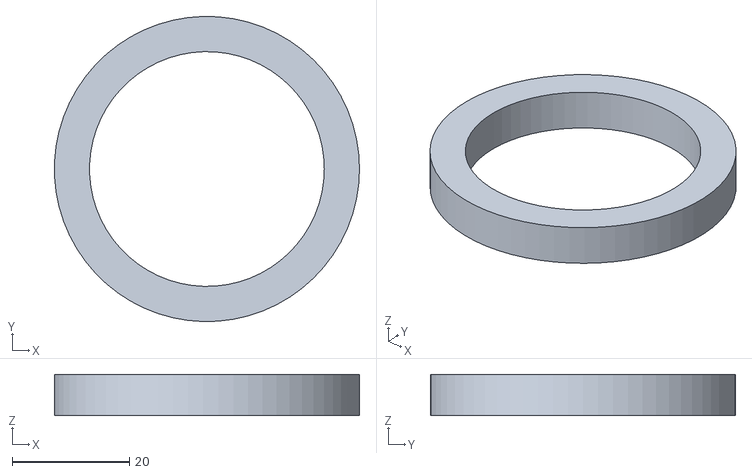
[picture p99: CAD file, 2026-10-11]
cad/parts/out_sts3215/ref/ref_pan_bearing.stl
52.0 x 52.0 x 7.00
