promaaa/vision-sobang/cad/torso_tank/out/ref_pump_r2.stl

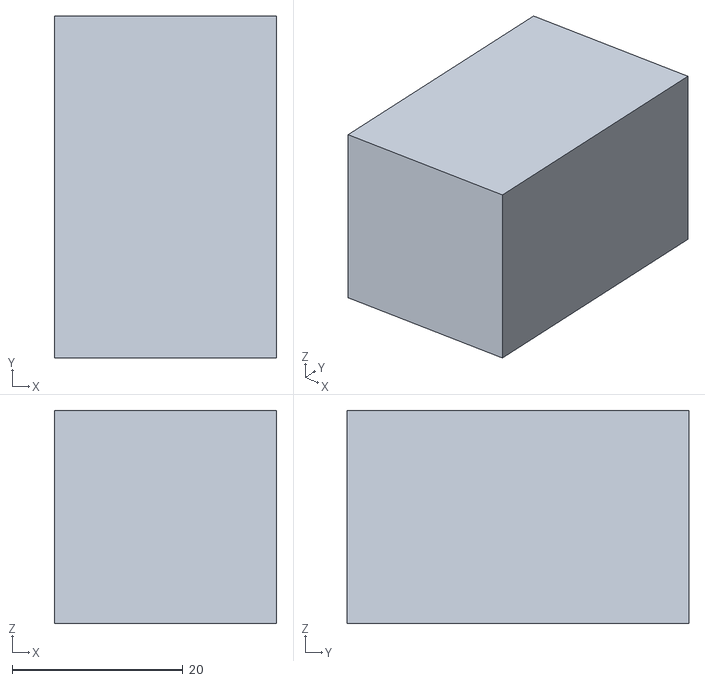
[picture p100: CAD file, 2026-10-13]
cad/torso_tank/out/ref_pump_r2.stl
26.0 x 40.0 x 25.0
