promaaa/vision-sobang/cad/backpack/out/bracket_upper.step

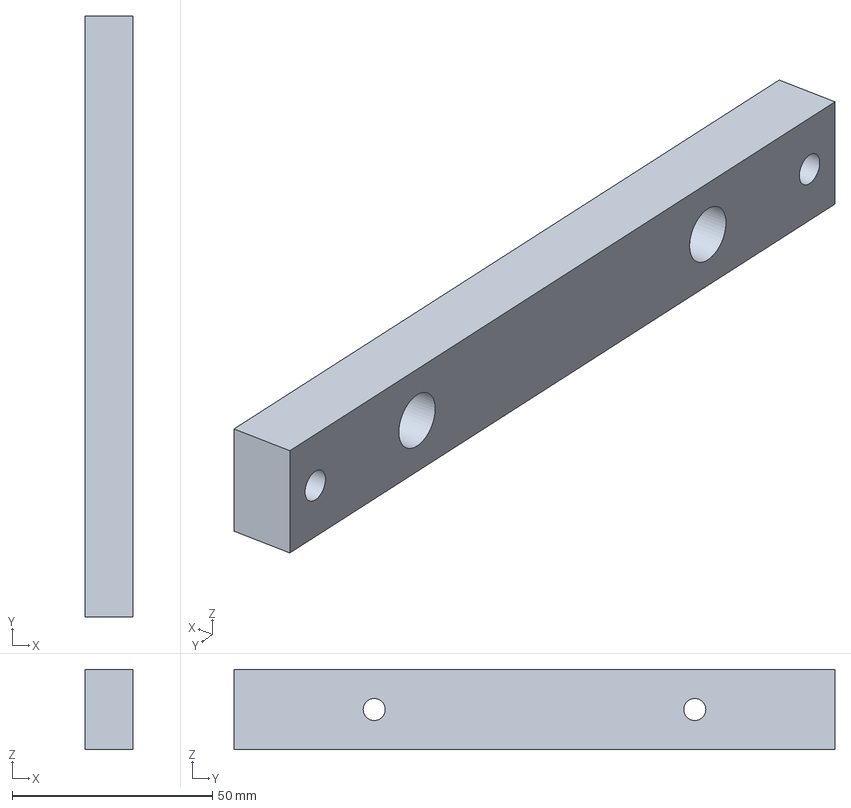
[picture p101: CAD file, 2026-10-11]
cad/backpack/out/bracket_upper.step
12.0 x 150.0 x 20.0 mm
