promaaa/vision-sobang/cad/bench/out/base_tripod.step

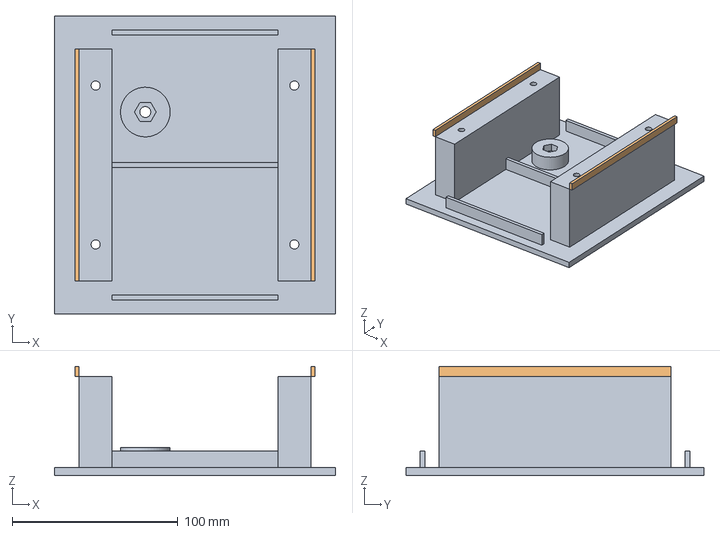
[picture p102: CAD file, 2026-10-11]
cad/bench/out/base_tripod.step
170.0 x 180.0 x 66.0 mm
