promaaa/vision-sobang/cad/bench/out/ref/ref_bottle.stl

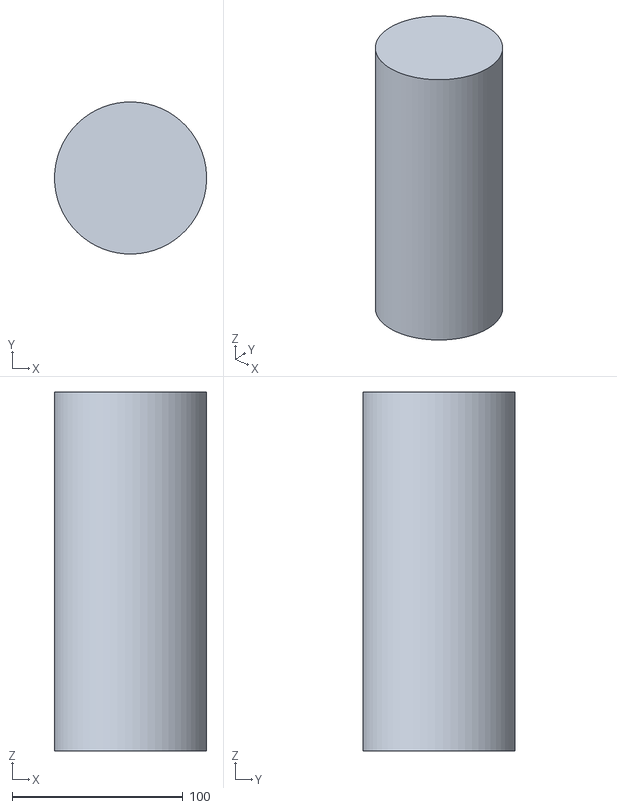
[picture p103: CAD file, 2026-10-11]
cad/bench/out/ref/ref_bottle.stl
88.9 x 89.0 x 210.0
