promaaa/vision-sobang/cad/parts/out/payload_plate.step

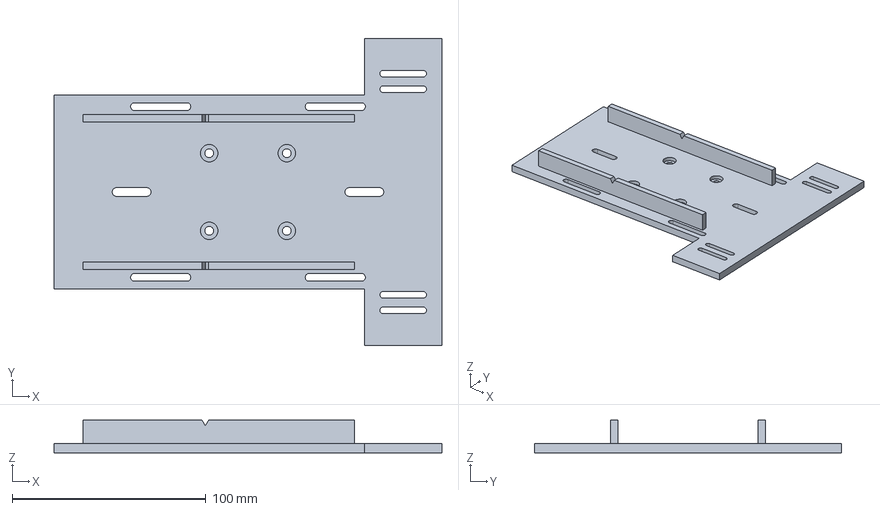
[picture p104: CAD file, 2026-10-11]
cad/parts/out/payload_plate.step
200.0 x 158.0 x 17.0 mm
