promaaa/vision-sobang/cad/parts/out_sts3215/pan_yoke.step

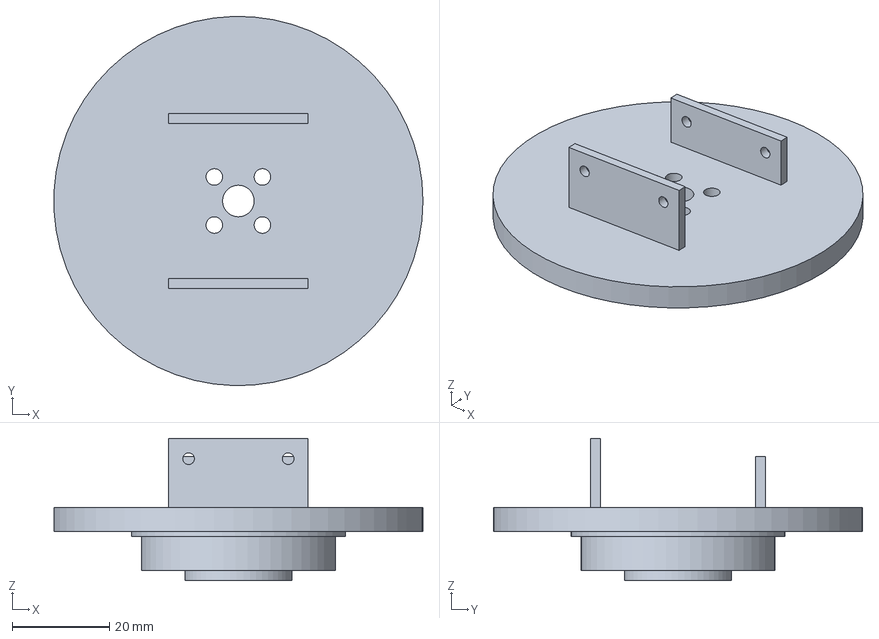
[picture p105: CAD file, 2026-10-11]
cad/parts/out_sts3215/pan_yoke.step
75.9 x 76.0 x 29.3 mm
