promaaa/vision-sobang/cad/parts/out_sts3215/ref/ref_cam_usb32.stl

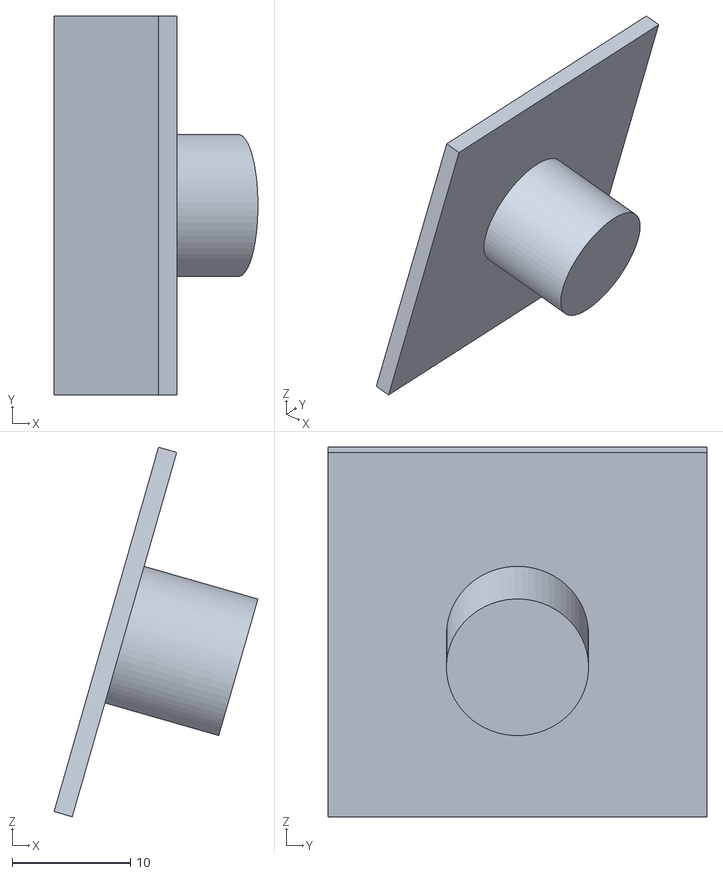
[picture p106: CAD file, 2026-10-11]
cad/parts/out_sts3215/ref/ref_cam_usb32.stl
17.2 x 32.0 x 31.2
