promaaa/vision-sobang/cad/torso_tank/out/water_r2_right.stl

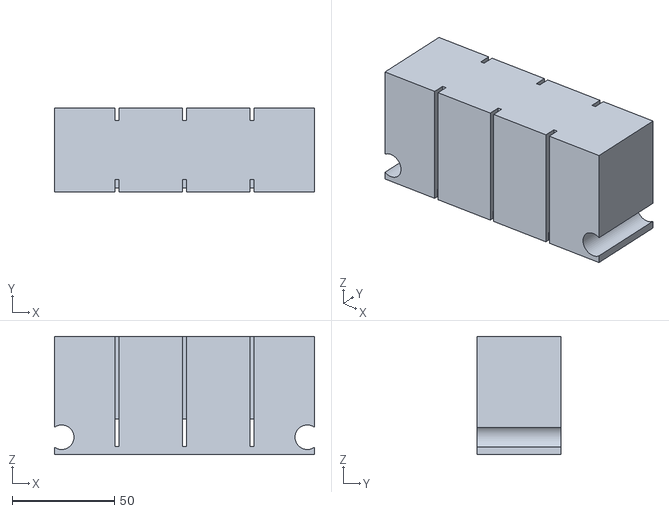
[picture p107: CAD file, 2026-10-13]
cad/torso_tank/out/water_r2_right.stl
127.0 x 41.0 x 57.8
