promaaa/vision-sobang/cad/backpack/out/plate.step

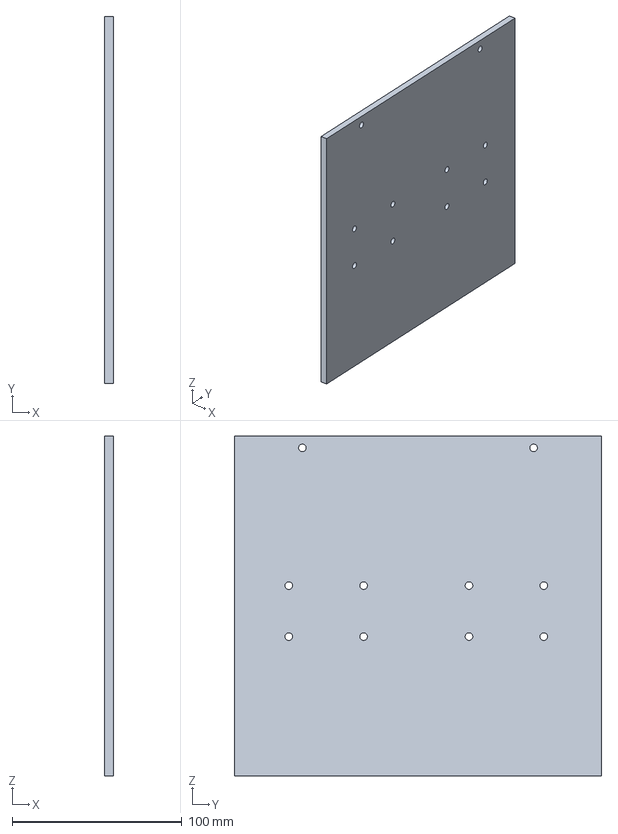
[picture p108: CAD file, 2026-10-11]
cad/backpack/out/plate.step
5.00 x 216.0 x 200.0 mm
