promaaa/vision-sobang/cad/bench/out/ebox_lid.step

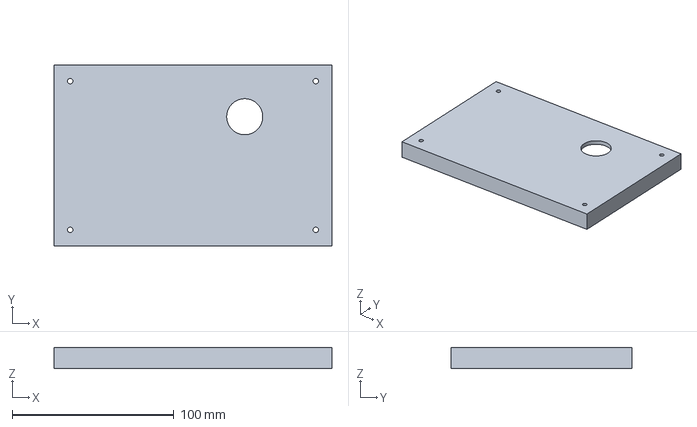
[picture p109: CAD file, 2026-10-11]
cad/bench/out/ebox_lid.step
172.0 x 112.0 x 13.0 mm
