promaaa/vision-sobang/cad/bench/out/ref/ref_rail_r.stl

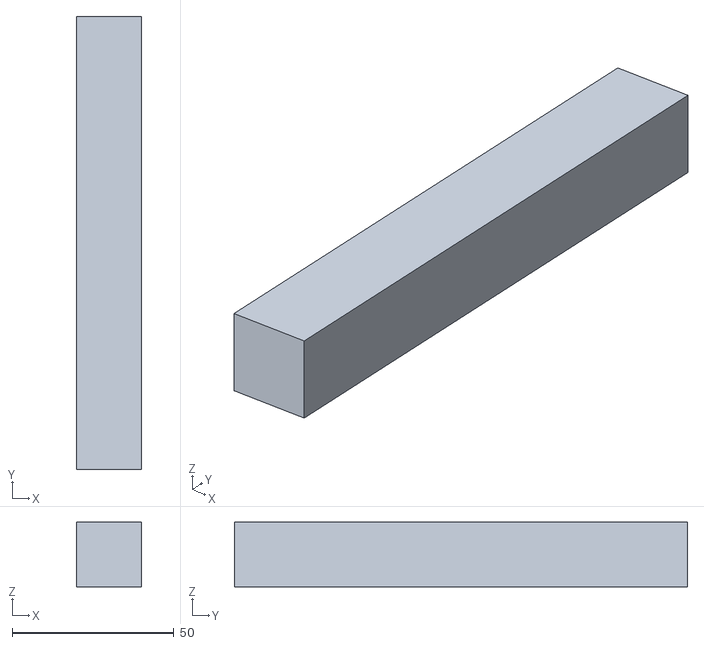
[picture p110: CAD file, 2026-10-11]
cad/bench/out/ref/ref_rail_r.stl
20.0 x 140.0 x 20.0
