promaaa/vision-sobang/cad/parts/out/ref/ref_gun.stl

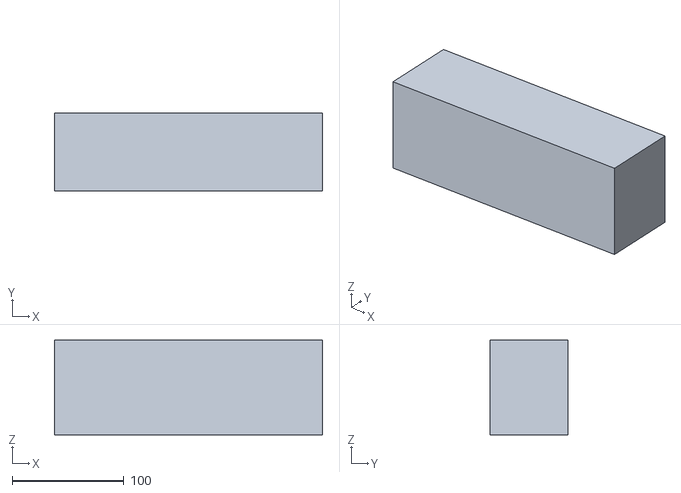
[picture p111: CAD file, 2026-10-11]
cad/parts/out/ref/ref_gun.stl
240.0 x 70.0 x 85.0
