promaaa/vision-sobang/cad/parts/out/tilt_u.step

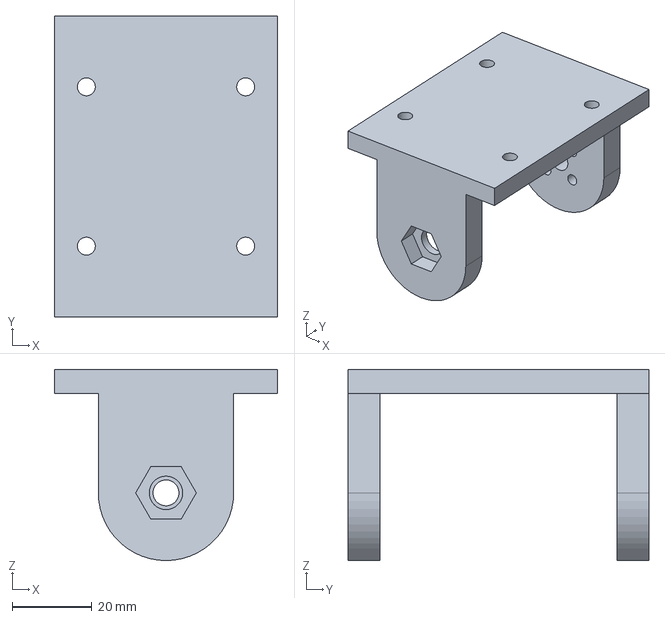
[picture p112: CAD file, 2026-10-11]
cad/parts/out/tilt_u.step
56.0 x 75.5 x 48.0 mm
