promaaa/vision-sobang/cad/parts/out_sts3215/pan_base.step

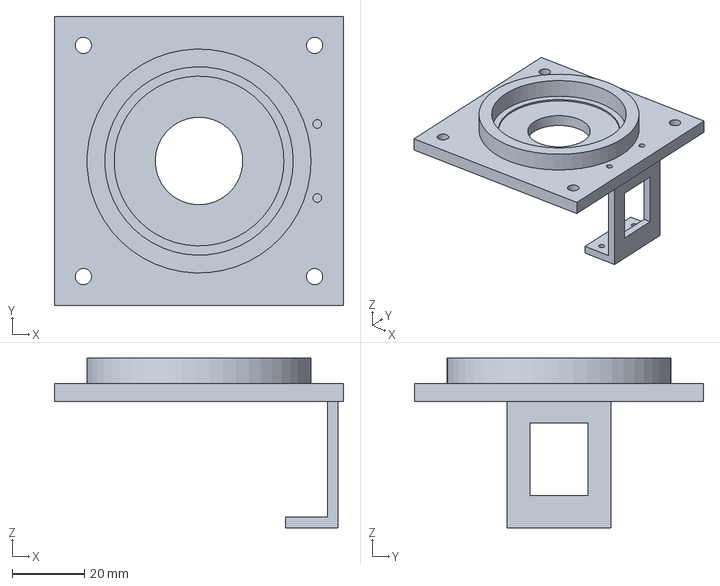
[picture p113: CAD file, 2026-10-11]
cad/parts/out_sts3215/pan_base.step
80.0 x 80.0 x 47.0 mm
