promaaa/vision-sobang/cad/torso_tank/out/water_r1.stl

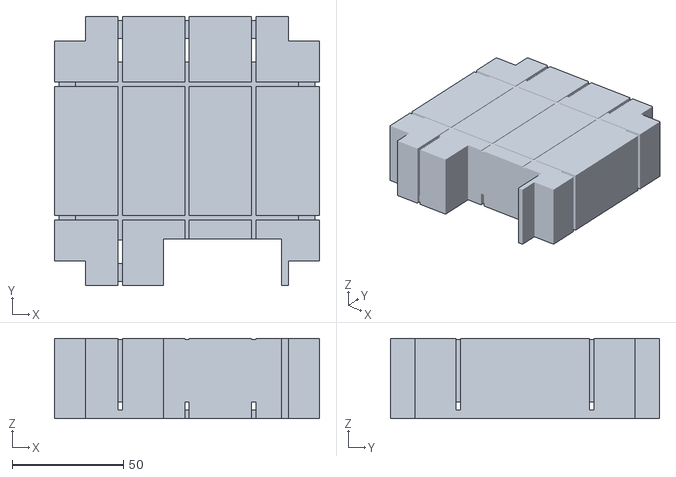
[picture p115: CAD file, 2026-10-13]
cad/torso_tank/out/water_r1.stl
119.0 x 121.0 x 36.1
