promaaa/vision-sobang/cad/backpack/out/cradle.step

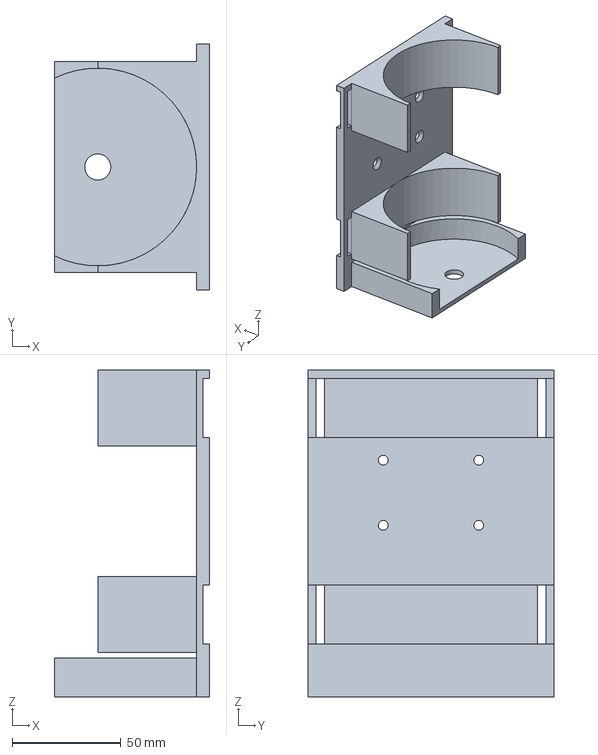
[picture p116: CAD file, 2026-10-11]
cad/backpack/out/cradle.step
71.5 x 113.0 x 150.5 mm
