promaaa/vision-sobang/cad/parts/out/pan_yoke.step

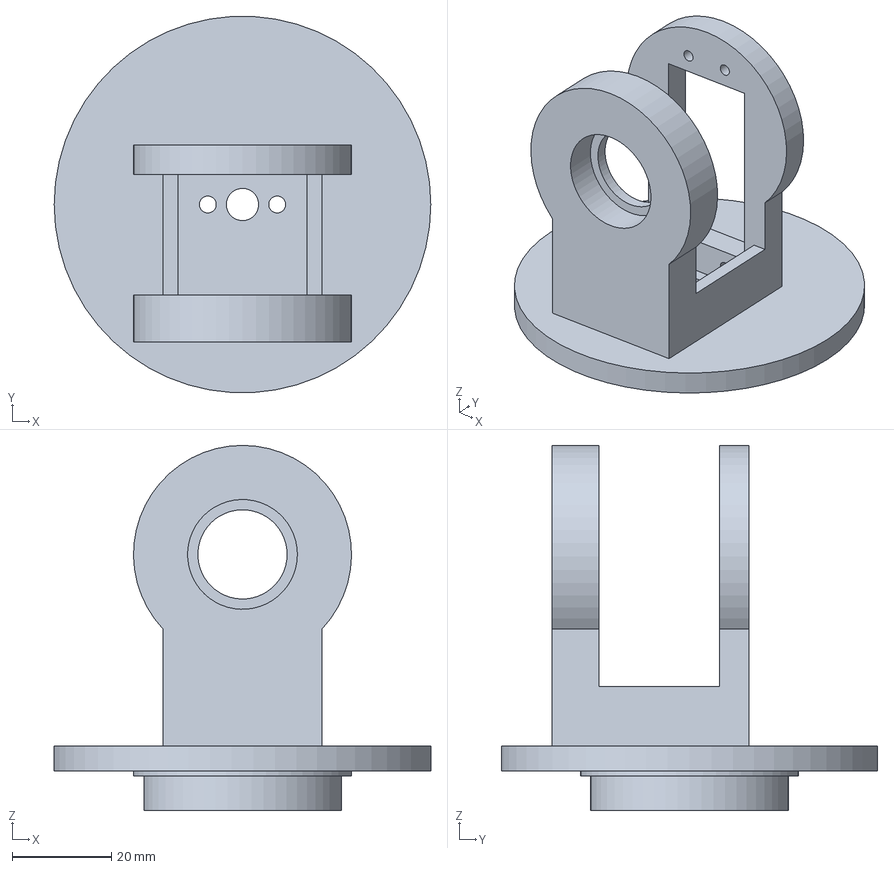
[picture p117: CAD file, 2026-10-11]
cad/parts/out/pan_yoke.step
76.0 x 75.9 x 73.7 mm
