promaaa/vision-sobang/cad/parts/out/ref/ref_cam_thermal.stl

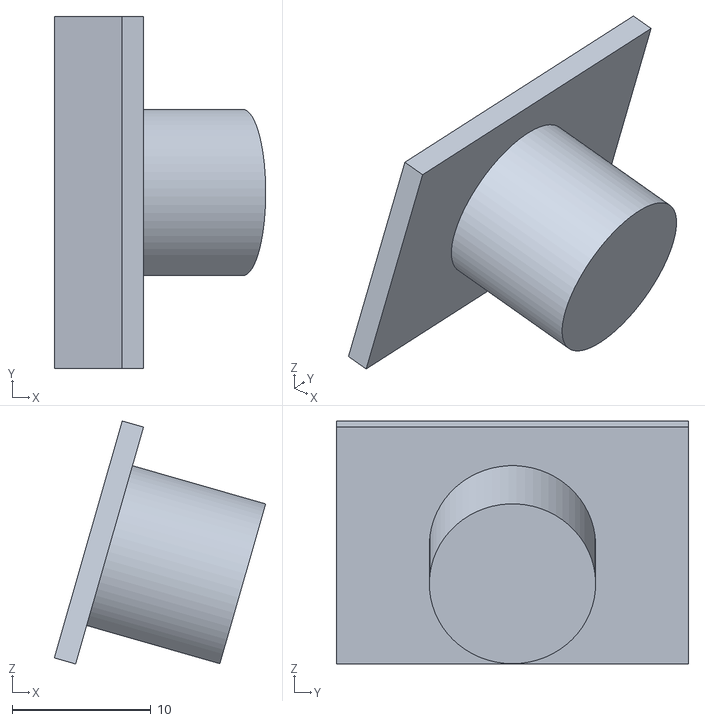
[picture p118: CAD file, 2026-10-11]
cad/parts/out/ref/ref_cam_thermal.stl
15.3 x 25.4 x 17.5
