promaaa/vision-sobang/cad/torso_tank/out/r1_deck.step

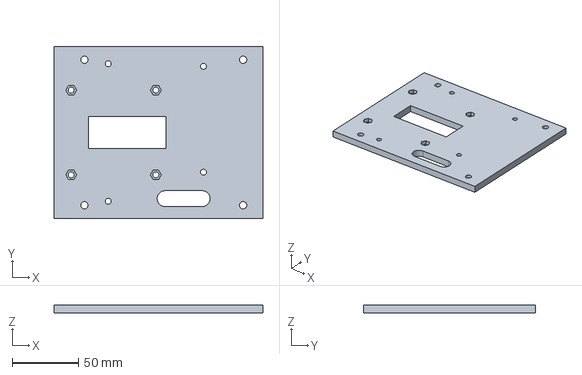
[picture p119: CAD file, 2026-10-13]
cad/torso_tank/out/r1_deck.step
158.0 x 130.0 x 6.00 mm
