promaaa/vision-sobang/cad/bench/out/tray.step

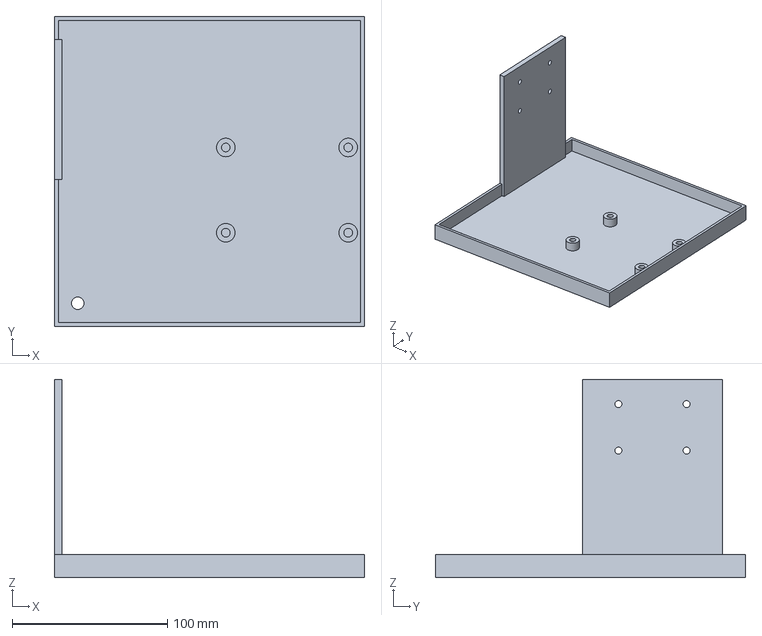
[picture p120: CAD file, 2026-10-11]
cad/bench/out/tray.step
200.0 x 200.0 x 128.0 mm
