promaaa/vision-sobang/cad/parts/out/ref/ref_tilt_pin.stl

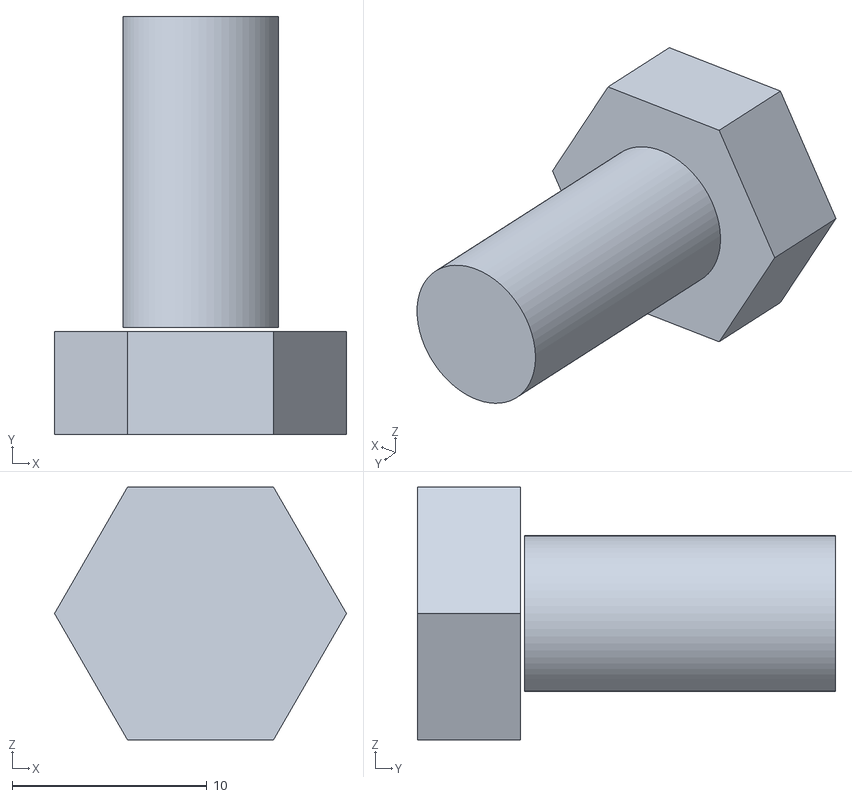
[picture p121: CAD file, 2026-10-11]
cad/parts/out/ref/ref_tilt_pin.stl
15.0 x 21.5 x 13.0
