promaaa/vision-sobang/cad/parts/out_sts3215/tilt_u.step

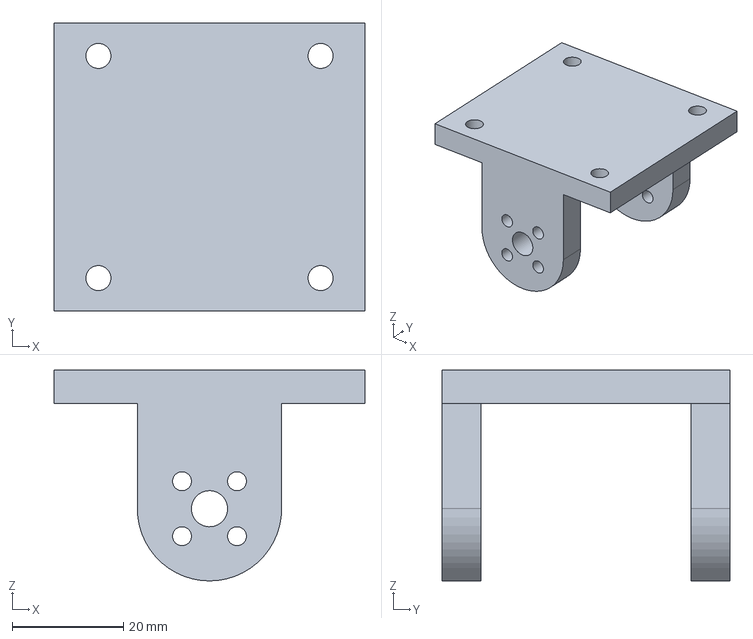
[picture p122: CAD file, 2026-10-11]
cad/parts/out_sts3215/tilt_u.step
56.0 x 51.8 x 38.0 mm
