promaaa/vision-sobang/cad/bench/out/ebox.step

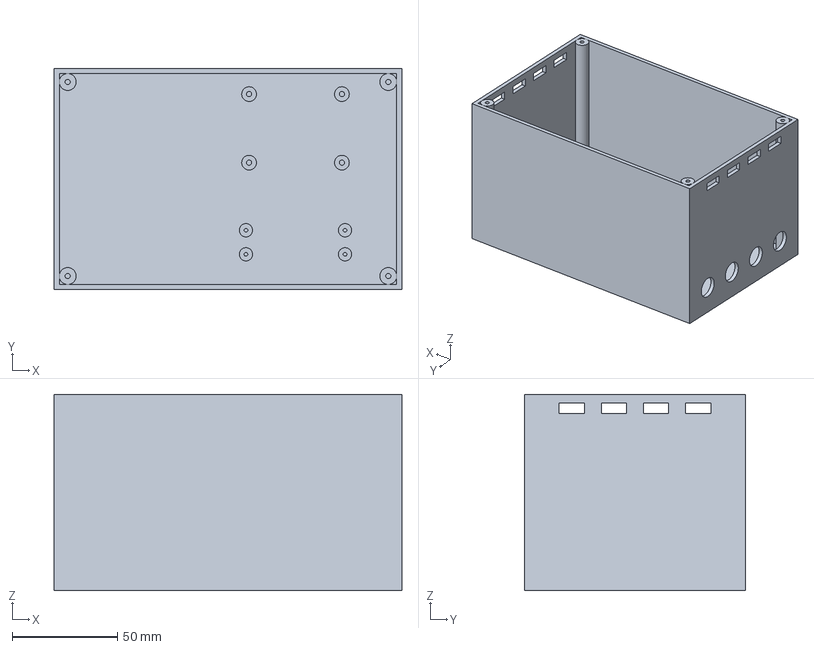
[picture p123: CAD file, 2026-10-11]
cad/bench/out/ebox.step
165.0 x 105.0 x 93.0 mm
