promaaa/vision-sobang/cad/parts/out/head_b.step

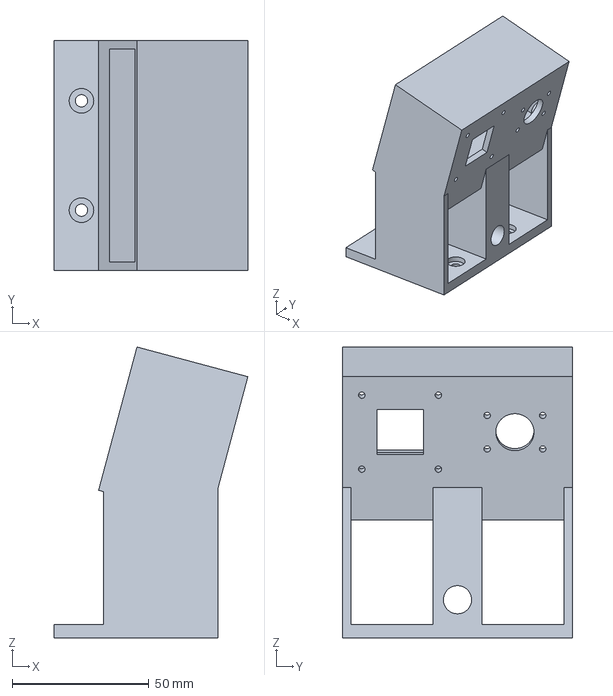
[picture p124: CAD file, 2026-10-11]
cad/parts/out/head_b.step
70.9 x 84.0 x 106.4 mm
