promaaa/vision-sobang/cad/parts/out/ref/ref_pan_servo.stl

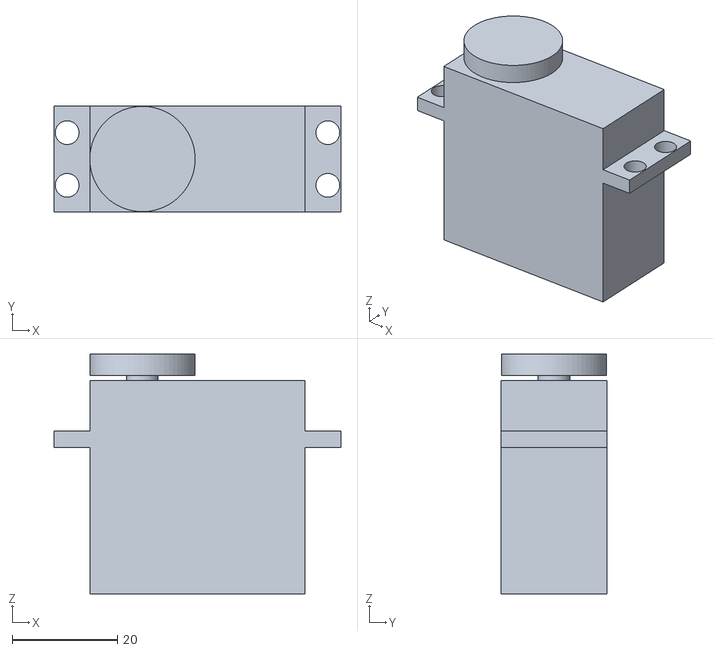
[picture p125: CAD file, 2026-10-11]
cad/parts/out/ref/ref_pan_servo.stl
54.5 x 20.1 x 45.5
