promaaa/vision-sobang/cad/parts/out_sts3215/cam_usb32.step

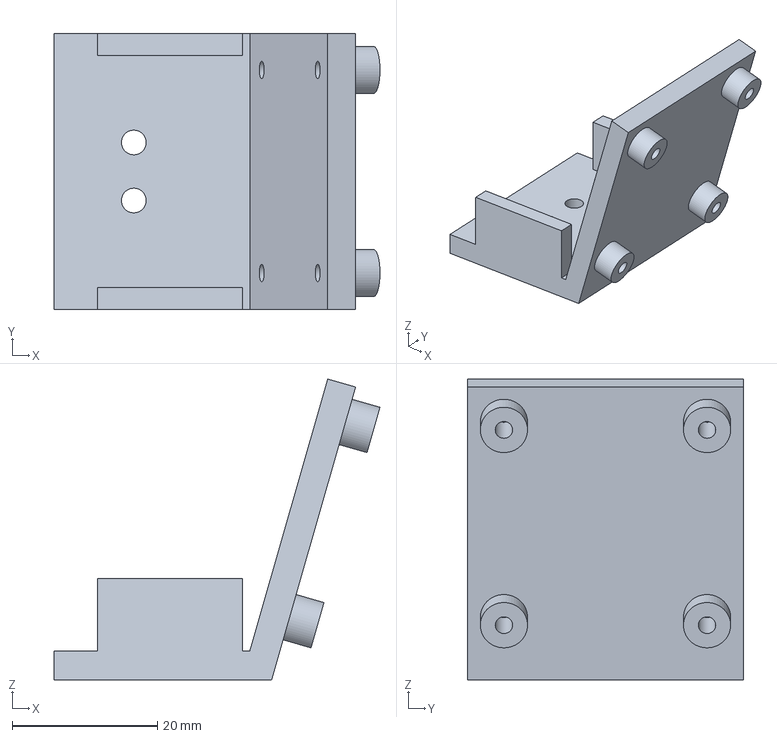
[picture p126: CAD file, 2026-10-11]
cad/parts/out_sts3215/cam_usb32.step
44.9 x 38.0 x 41.5 mm
