promaaa/vision-sobang/cad/backpack/out/pump_bracket.step

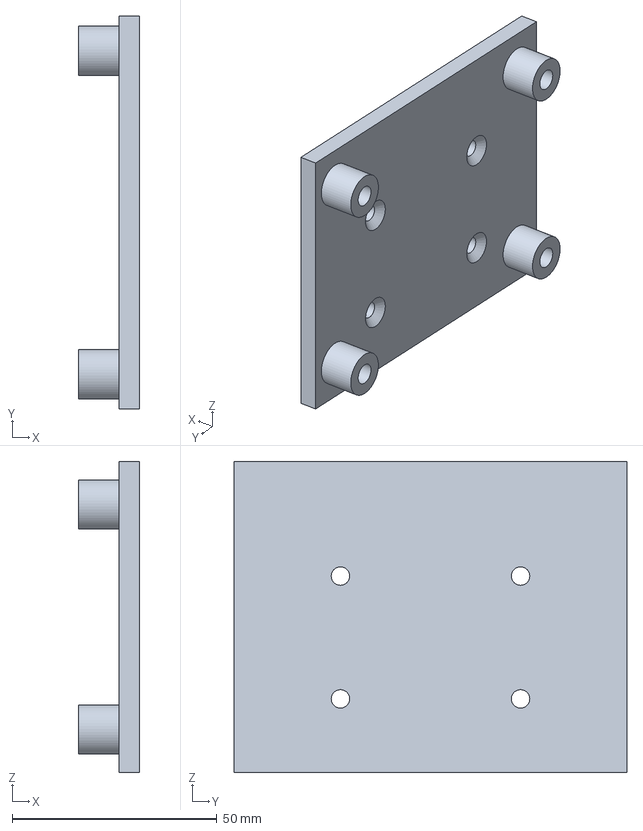
[picture p127: CAD file, 2026-10-11]
cad/backpack/out/pump_bracket.step
15.0 x 96.0 x 76.0 mm
