promaaa/vision-sobang/cad/parts/out/valve_e.step

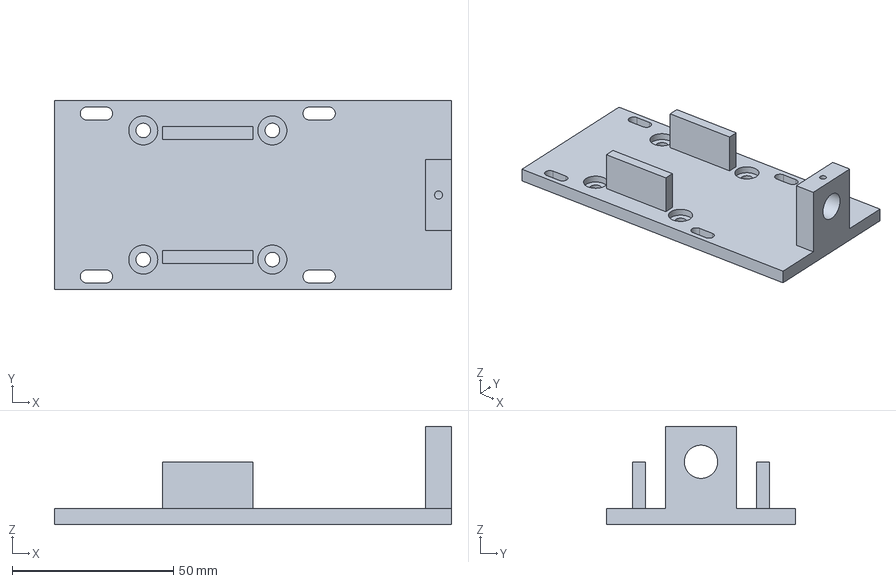
[picture p128: CAD file, 2026-10-11]
cad/parts/out/valve_e.step
123.0 x 58.5 x 30.5 mm
