promaaa/vision-sobang/cad/parts/out_sts3215/deck.step

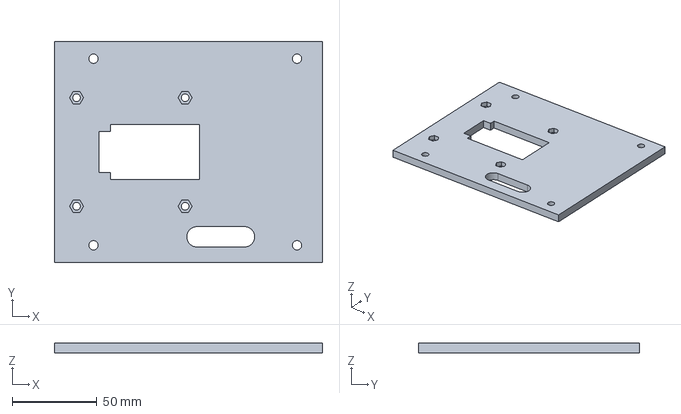
[picture p129: CAD file, 2026-10-11]
cad/parts/out_sts3215/deck.step
158.0 x 130.0 x 6.00 mm
