promaaa/vision-sobang/cad/torso_tank/out/r1_half_left.step

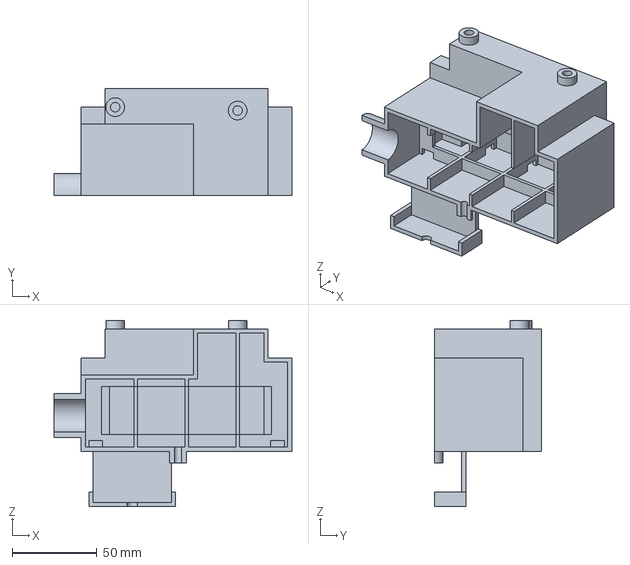
[picture p130: CAD file, 2026-10-13]
cad/torso_tank/out/r1_half_left.step
140.0 x 63.0 x 109.5 mm
