promaaa/vision-sobang/cad/backpack/out/guard_upper.step

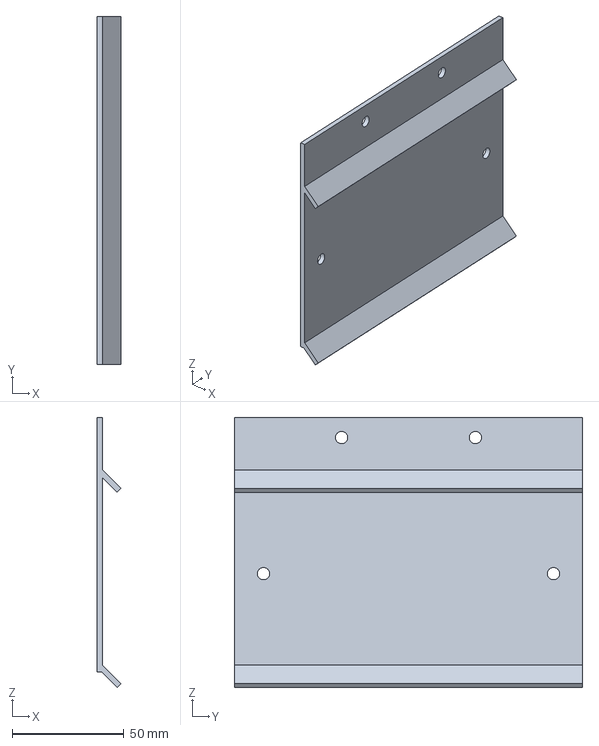
[picture p131: CAD file, 2026-10-11]
cad/backpack/out/guard_upper.step
10.8 x 156.0 x 121.1 mm
