promaaa/vision-sobang/cad/parts/out/pan_base.step

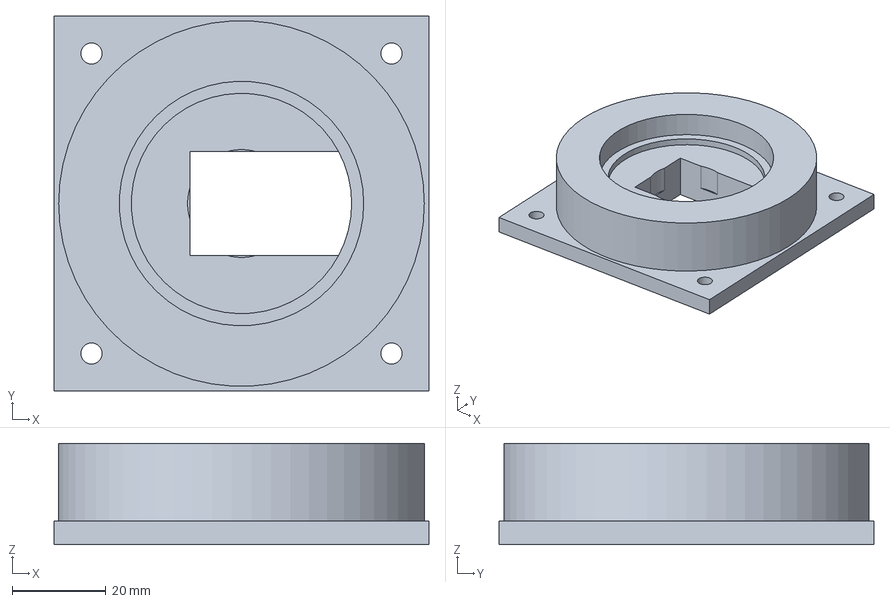
[picture p132: CAD file, 2026-10-11]
cad/parts/out/pan_base.step
80.0 x 80.0 x 21.6 mm
