promaaa/vision-sobang/cad/torso_tank/out/r2_pump_holder.step

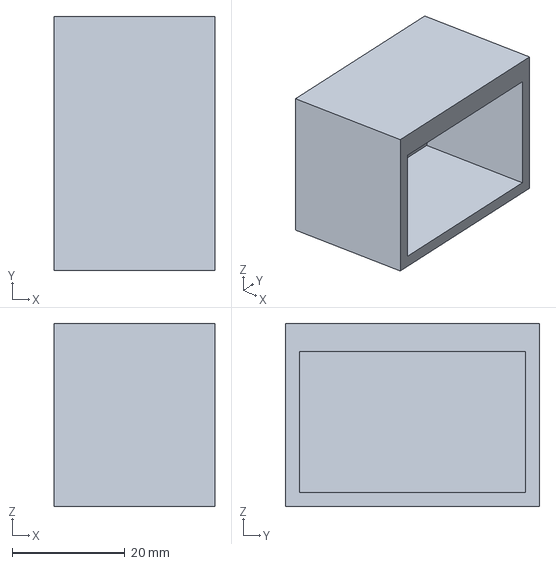
[picture p133: CAD file, 2026-10-13]
cad/torso_tank/out/r2_pump_holder.step
28.5 x 45.0 x 32.5 mm
