promaaa/vision-sobang/cad/backpack/out/guard_lower.step

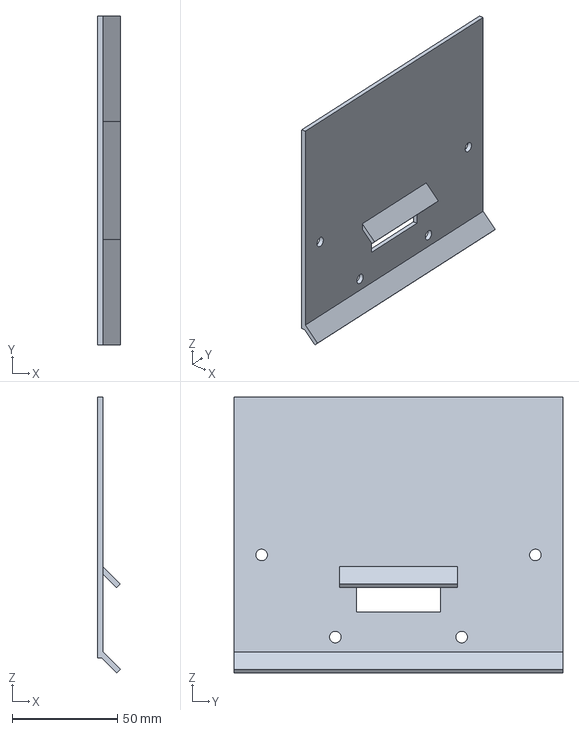
[picture p134: CAD file, 2026-10-11]
cad/backpack/out/guard_lower.step
10.8 x 156.0 x 131.1 mm
