promaaa/vision-sobang/cad/torso_tank/out/r2_inner_plate.step

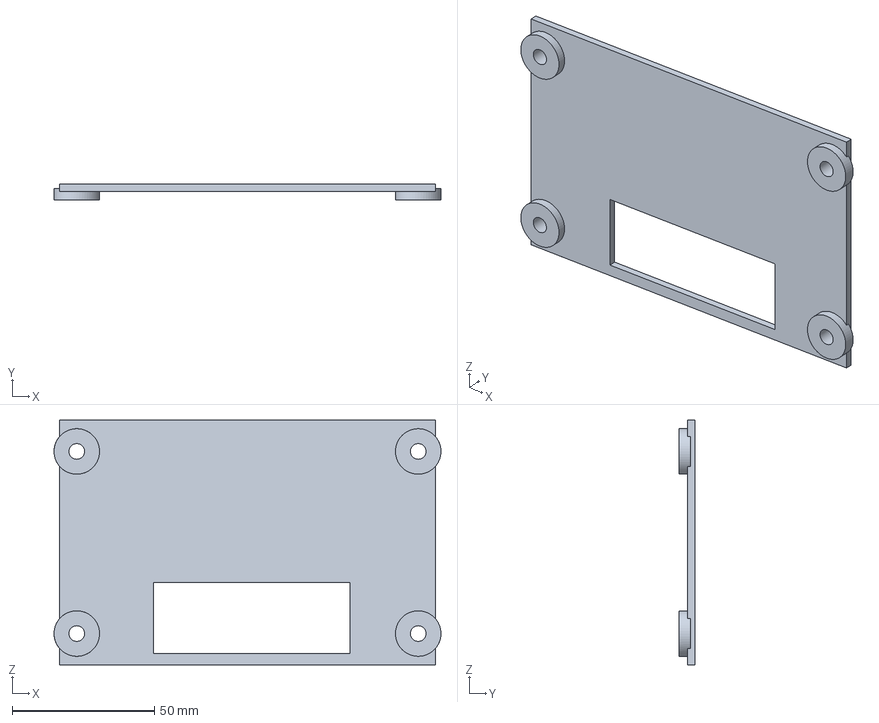
[picture p135: CAD file, 2026-10-13]
cad/torso_tank/out/r2_inner_plate.step
136.0 x 5.50 x 86.0 mm
