promaaa/vision-sobang/cad/torso_tank/out/r2_tank_right.step

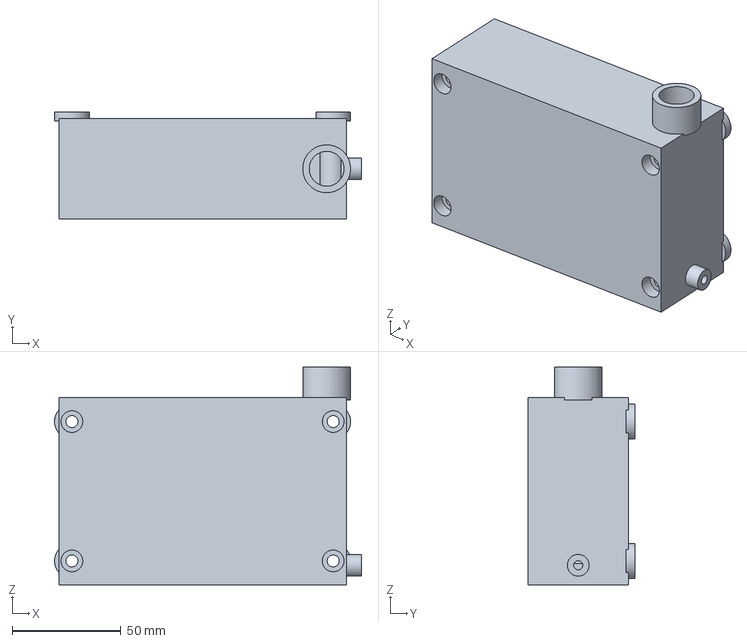
[picture p136: CAD file, 2026-10-13]
cad/torso_tank/out/r2_tank_right.step
141.0 x 49.0 x 100.0 mm
