promaaa/vision-sobang/cad/torso_tank/out/r1_tank.step

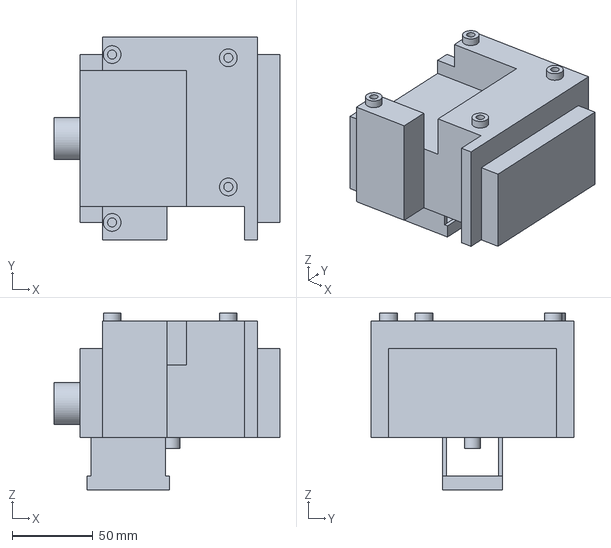
[picture p137: CAD file, 2026-10-13]
cad/torso_tank/out/r1_tank.step
140.0 x 126.0 x 109.5 mm
