promaaa/vision-sobang/cad/torso_tank/out/r2_tub.step

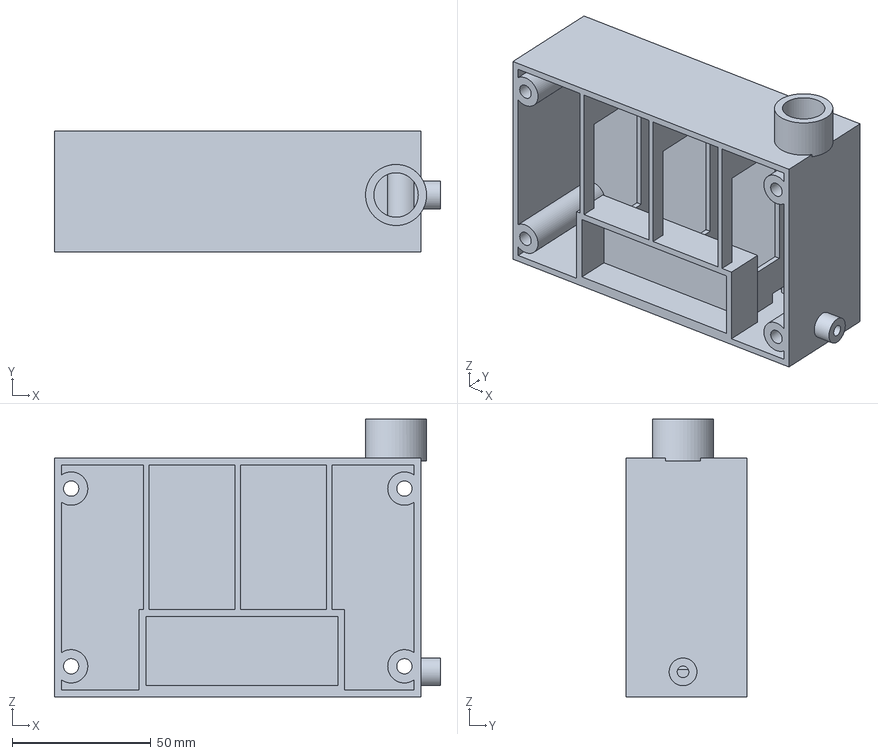
[picture p138: CAD file, 2026-10-13]
cad/torso_tank/out/r2_tub.step
139.0 x 43.5 x 100.0 mm
