promaaa/vision-sobang/(list of files, cad)

Other CAD files:
cad/parts/out/ref/ref_pan_bearing.stl
cad/bench/out/cradle.step
cad/bench/out/ref/ref_rail_f.stl
cad/parts/out_sts3215/payload_plate.step
cad/parts/out_sts3215/ref/ref_cam_thermal.stl
cad/backpack/out/ref_tank.step
cad/parts/out/cam_mlx90640.step
cad/parts/out_sts3215/ref/ref_pan_servo.stl
cad/torso_tank/out/ref_pump_r1.stl
cad/backpack/out/ref_pump.step
cad/parts/out_sts3215/ref/ref_gun.stl
cad/torso_tank/out/water_r2_left.stl
cad/parts/out/ref/ref_cam_usb32.stl
cad/parts/out/ref/ref_tilt_servo.stl
cad/parts/out/deck.step
cad/parts/out/cam_usb32.step
cad/torso_tank/out/r2_tank_left.step
cad/backpack/out/bracket_lower.stl
cad/backpack/out/bracket_upper.stl
cad/backpack/out/cradle.stl
cad/backpack/out/guard_lower.stl
cad/backpack/out/guard_upper.stl
cad/backpack/out/plate.stl
cad/backpack/out/pump_bracket.stl
cad/backpack/out/ref_pump.stl
cad/backpack/out/ref_tank.stl
cad/bench/out/base_clamp.stl
cad/bench/out/base_tripod.stl
cad/bench/out/cradle.stl
cad/bench/out/ebox.stl
cad/bench/out/ebox_lid.stl
cad/bench/out/tray.stl
cad/parts/out/cam_mlx90640.stl
cad/parts/out/cam_purethermal.stl
cad/parts/out/cam_usb32.stl
cad/parts/out/deck.stl
cad/parts/out/head_b.stl
cad/parts/out/pan_base.stl
cad/parts/out/pan_yoke.stl
cad/parts/out/payload_plate.stl
cad/parts/out/tilt_u.stl
cad/parts/out/valve_e.stl
cad/parts/out_sts3215/cam_mlx90640.stl
cad/parts/out_sts3215/cam_usb32.stl
cad/parts/out_sts3215/deck.stl
cad/parts/out_sts3215/pan_base.stl
cad/parts/out_sts3215/pan_yoke.stl
cad/parts/out_sts3215/payload_plate.stl
cad/parts/out_sts3215/tilt_u.stl
cad/torso_tank/out/r1_deck.stl
cad/torso_tank/out/r1_half_left.stl
cad/torso_tank/out/r1_half_right.stl
cad/torso_tank/out/r1_tank.stl
cad/torso_tank/out/r2_inner_plate.stl
cad/torso_tank/out/r2_pump_holder.stl
cad/torso_tank/out/r2_tank_left.stl
cad/torso_tank/out/r2_tank_right.stl
cad/torso_tank/out/r2_tub.stl
