promaaa/vision-sobang/cad/parts/renders/module_assembled_rear.jpg

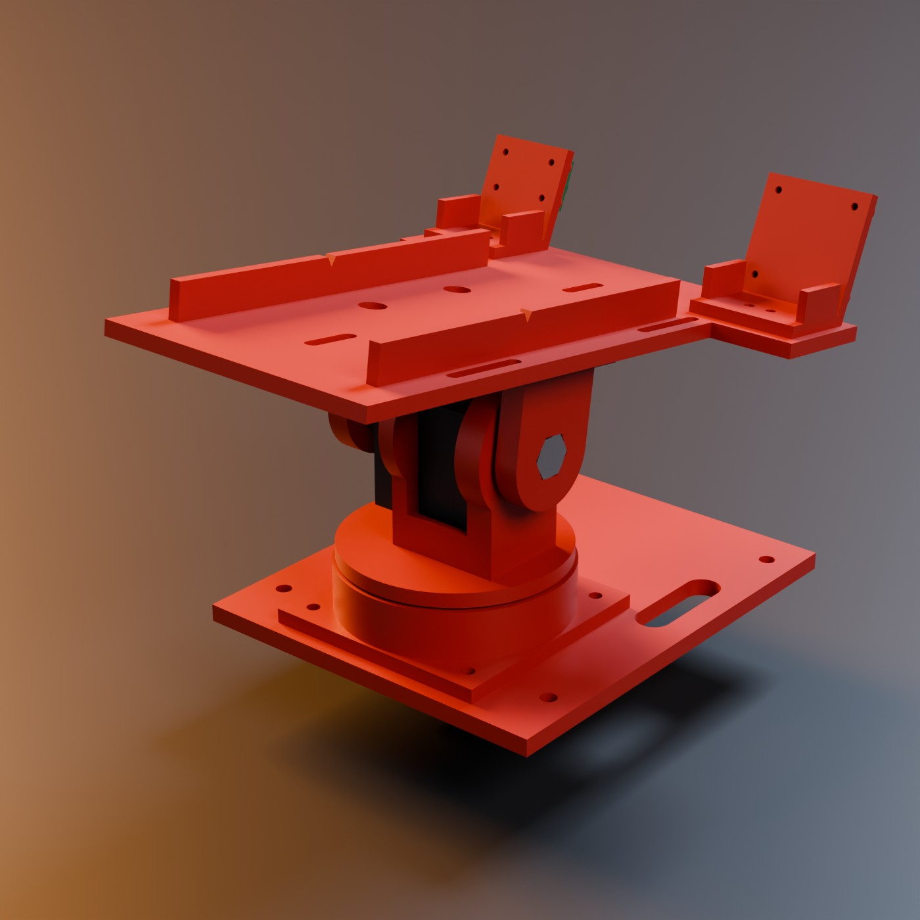
cad/parts/renders/module_assembled_rear.jpg
