promaaa/vision-sobang/sim/payload/results/a_variants.md

### A variants: worst case over pan (0, ±45, ±90°) and tilt (-30, 0, +20°), no counterweight

| Pan axis x (m) | Gun offset D (m) | CoM fore-aft range (mm) | CoM sideways range (mm) | Worst single-leg pitch torque (Nm, at pan / tilt) | Worst single-leg torque, all joints (Nm, at pan / tilt) | Stand peak at pan 0, tilt 0 (Nm) | Crouch peak at pan 0, tilt 0 (Nm) |
|---|---|---|---|---|---|---|---|
| +0.02 | 0.05 | +5 to +11 | -5 to +5 | 6.5 (+0° / -30°) | 9.1 (+90° / -30°) | 2.6 | 3.9 |
| +0.02 | 0.10 | +5 to +15 | -9 to +9 | 7.0 (+0° / +0°) | 9.5 (+90° / -30°) | 2.8 | 4.2 |
| -0.02 | 0.05 | +1 to +7 | -5 to +5 | 6.0 (+0° / -30°) | 9.1 (+90° / -30°) | 2.3 | 3.7 |
| -0.02 | 0.10 | +1 to +11 | -9 to +9 | 6.5 (+0° / +0°) | 9.4 (+90° / -30°) | 2.6 | 3.9 |
| -0.06 | 0.05 | -3 to +3 | -5 to +5 | 5.6 (+0° / -30°) | 9.1 (+90° / -30°) | 2.0 | 3.4 |
| -0.06 | 0.10 | -3 to +6 | -9 to +9 | 6.0 (+0° / +0°) | 9.4 (+90° / -30°) | 2.3 | 3.7 |

### A variants: counterweight, worst single-leg pitch torque over all pan and tilt angles (Nm)

| Pan axis x (m) | Gun offset D (m) | none | 0.3 kg at x -0.12 | 0.5 kg at x -0.12 | battery 0.6 kg moved x 0 -> -0.12 |
|---|---|---|---|---|---|
| +0.02 | 0.05 | 6.5 | 6.4 | 6.3 | 5.9 |
| +0.02 | 0.10 | 7.0 | 6.9 | 6.8 | 6.3 |
| -0.02 | 0.05 | 6.0 | 5.9 | 5.8 | 5.4 |
| -0.02 | 0.10 | 6.5 | 6.4 | 6.3 | 5.8 |
| -0.06 | 0.05 | 5.6 | 5.4 | 5.3 | 4.9 |
| -0.06 | 0.10 | 6.0 | 5.9 | 5.8 | 5.3 |

### Pan and tilt effect at pan axis x = +0.02 m, gun offset D = 0.10 m, no counterweight

| Pan (°) | Tilt (°) | CoM fore-aft (mm) | CoM sideways (mm) | Left stance: pitch / all joints (Nm) | Right stance: pitch / all joints (Nm) |
|---|---|---|---|---|---|
| +0 | -30 | +14 | +0 | 6.9 / 8.5 | 7.0 / 8.6 |
| +0 | +0 | +15 | +0 | 7.0 / 8.5 | 7.0 / 8.6 |
| +0 | +20 | +14 | +0 | 6.8 / 8.5 | 6.9 / 8.6 |
| +45 | -30 | +12 | +7 | 6.4 / 7.8 | 6.7 / 9.3 |
| +45 | +0 | +12 | +6 | 6.5 / 7.8 | 6.8 / 9.2 |
| +45 | +20 | +11 | +5 | 6.4 / 7.9 | 6.7 / 9.1 |
| -45 | -30 | +12 | -6 | 6.8 / 9.2 | 6.5 / 7.9 |
| -45 | +0 | +12 | -6 | 6.8 / 9.2 | 6.6 / 7.9 |
| -45 | +20 | +12 | -5 | 6.7 / 9.0 | 6.5 / 8.0 |
| +90 | -30 | +5 | +9 | 5.6 / 7.5 | 6.0 / 9.5 |
| +90 | +0 | +6 | +9 | 5.7 / 7.5 | 6.1 / 9.4 |
| +90 | +20 | +6 | +7 | 5.7 / 7.7 | 6.1 / 9.3 |
| -90 | -30 | +6 | -9 | 6.1 / 9.4 | 5.7 / 7.6 |
| -90 | +0 | +6 | -9 | 6.1 / 9.4 | 5.8 / 7.6 |
| -90 | +20 | +7 | -7 | 6.2 / 9.3 | 5.8 / 7.7 |

### Pan and tilt effect at pan axis x = -0.02 m, gun offset D = 0.10 m, no counterweight

| Pan (°) | Tilt (°) | CoM fore-aft (mm) | CoM sideways (mm) | Left stance: pitch / all joints (Nm) | Right stance: pitch / all joints (Nm) |
|---|---|---|---|---|---|
| +0 | -30 | +10 | +0 | 6.4 / 8.5 | 6.5 / 8.6 |
| +0 | +0 | +11 | +0 | 6.5 / 8.5 | 6.5 / 8.6 |
| +0 | +20 | +9 | +0 | 6.4 / 8.5 | 6.4 / 8.6 |
| +45 | -30 | +7 | +7 | 5.9 / 7.8 | 6.2 / 9.2 |
| +45 | +0 | +8 | +6 | 6.0 / 7.8 | 6.3 / 9.2 |
| +45 | +20 | +7 | +5 | 5.9 / 7.9 | 6.2 / 9.1 |
| -45 | -30 | +8 | -6 | 6.3 / 9.2 | 6.0 / 7.9 |
| -45 | +0 | +8 | -6 | 6.3 / 9.1 | 6.1 / 7.9 |
| -45 | +20 | +8 | -5 | 6.2 / 9.0 | 6.0 / 8.0 |
| +90 | -30 | +1 | +9 | 5.1 / 7.5 | 5.5 / 9.4 |
| +90 | +0 | +2 | +9 | 5.2 / 7.5 | 5.5 / 9.4 |
| +90 | +20 | +2 | +7 | 5.2 / 7.7 | 5.6 / 9.3 |
| -90 | -30 | +2 | -9 | 5.6 / 9.4 | 5.2 / 7.6 |
| -90 | +0 | +2 | -9 | 5.6 / 9.4 | 5.3 / 7.6 |
| -90 | +20 | +3 | -7 | 5.7 / 9.2 | 5.3 / 7.7 |

### Pan and tilt effect at pan axis x = -0.06 m, gun offset D = 0.10 m, no counterweight

| Pan (°) | Tilt (°) | CoM fore-aft (mm) | CoM sideways (mm) | Left stance: pitch / all joints (Nm) | Right stance: pitch / all joints (Nm) |
|---|---|---|---|---|---|
| +0 | -30 | +6 | +0 | 5.9 / 8.5 | 6.0 / 8.6 |
| +0 | +0 | +6 | +0 | 6.0 / 8.5 | 6.0 / 8.6 |
| +0 | +20 | +5 | +0 | 5.9 / 8.5 | 5.9 / 8.6 |
| +45 | -30 | +3 | +7 | 5.4 / 7.8 | 5.7 / 9.2 |
| +45 | +0 | +4 | +6 | 5.5 / 7.8 | 5.8 / 9.2 |
| +45 | +20 | +3 | +5 | 5.4 / 7.9 | 5.7 / 9.1 |
| -45 | -30 | +4 | -6 | 5.8 / 9.2 | 5.5 / 7.9 |
| -45 | +0 | +4 | -6 | 5.8 / 9.1 | 5.6 / 7.9 |
| -45 | +20 | +3 | -5 | 5.7 / 9.0 | 5.5 / 8.0 |
| +90 | -30 | -3 | +9 | 4.6 / 7.5 | 5.0 / 9.4 |
| +90 | +0 | -2 | +9 | 4.7 / 7.5 | 5.0 / 9.4 |
| +90 | +20 | -2 | +7 | 4.7 / 7.7 | 5.1 / 9.3 |
| -90 | -30 | -2 | -9 | 5.1 / 9.4 | 4.7 / 7.5 |
| -90 | +0 | -2 | -9 | 5.1 / 9.4 | 4.8 / 7.5 |
| -90 | +20 | -1 | -7 | 5.1 / 9.2 | 4.8 / 7.7 |

### Model files: A v0 (first version) and A v1 (new bhl_A.xml)

| Model | CoM fore-aft (mm) | Stand peak (Nm) | Crouch peak (Nm) | Single-leg pitch peak (Nm) | Single-leg peak, all joints (Nm) | kp 50 / kd 2 / 6 Nm | kp 200 / kd 5 / 6 Nm | Push fwd / back (N s), kp 200 / kd 5 / 20 Nm |
|---|---|---|---|---|---|---|---|---|
| A_v0 | +6 | 2.3 | 3.6 | 5.9 | 8.6 | falls at 1.5 s | stands, 2.6 Nm | 5.6 / 6.7 |
| A | +6 | 2.3 | 3.7 | 6.0 | 8.6 | falls at 1.4 s | stands, 2.6 Nm | 5.6 / 6.9 |
