promaaa/vision-sobang/sim/payload/results/heat.md

#### bhl_A_real_6Nm_kick: 60 s, path 16.1 m, no fall

| Joint | RMS torque (Nm) | Peak (Nm) | Time above 4 Nm (%) | Time at the limit (%) | RMS motor current (A, estimate) | Copper loss (W, estimate) |
|---|---|---|---|---|---|---|
| left_hip_roll | 3.52 | 6.00 | 37.8 | 7.9 | 2.8 | 0.5 to 0.8 |
| left_hip_yaw | 3.60 | 6.00 | 40.4 | 15.1 | 2.9 | 0.5 to 0.8 |
| left_hip_pitch | 2.17 | 6.00 | 9.1 | 1.7 | 1.7 | 0.2 to 0.3 |
| left_knee_pitch | 2.57 | 6.00 | 14.9 | 9.1 | 2.1 | 0.3 to 0.4 |
| left_ankle_pitch | 3.26 | 6.00 | 27.4 | 16.0 | 2.1 | 0.9 to 1.3 |
| left_ankle_roll | 2.34 | 5.49 | 11.8 | 0.0 | 1.5 | 0.4 to 0.7 |
| right_hip_roll | 3.31 | 6.00 | 33.2 | 1.7 | 2.7 | 0.4 to 0.7 |
| right_hip_yaw | 3.46 | 6.00 | 38.9 | 10.8 | 2.8 | 0.5 to 0.7 |
| right_hip_pitch | 2.24 | 6.00 | 10.3 | 2.1 | 1.8 | 0.2 to 0.3 |
| right_knee_pitch | 2.78 | 6.00 | 17.4 | 10.3 | 2.2 | 0.3 to 0.5 |
| right_ankle_pitch | 2.97 | 6.00 | 21.2 | 12.3 | 1.9 | 0.7 to 1.1 |
| right_ankle_roll | 2.37 | 5.84 | 12.7 | 0.0 | 1.5 | 0.5 to 0.7 |

#### bhl_B_real_6Nm_kick: 60 s, path 8.0 m, no fall

| Joint | RMS torque (Nm) | Peak (Nm) | Time above 4 Nm (%) | Time at the limit (%) | RMS motor current (A, estimate) | Copper loss (W, estimate) |
|---|---|---|---|---|---|---|
| left_hip_roll | 2.39 | 6.00 | 16.8 | 0.9 | 1.9 | 0.2 to 0.4 |
| left_hip_yaw | 3.04 | 6.00 | 24.5 | 17.5 | 2.5 | 0.4 to 0.6 |
| left_hip_pitch | 2.42 | 6.00 | 6.1 | 2.2 | 1.9 | 0.2 to 0.4 |
| left_knee_pitch | 3.03 | 6.00 | 20.8 | 12.9 | 2.4 | 0.4 to 0.6 |
| left_ankle_pitch | 2.49 | 6.00 | 13.2 | 5.7 | 1.6 | 0.5 to 0.8 |
| left_ankle_roll | 1.54 | 6.00 | 2.9 | 0.0 | 1.0 | 0.2 to 0.3 |
| right_hip_roll | 2.34 | 6.00 | 13.1 | 0.8 | 1.9 | 0.2 to 0.3 |
| right_hip_yaw | 2.79 | 6.00 | 19.7 | 12.6 | 2.2 | 0.3 to 0.5 |
| right_hip_pitch | 2.07 | 6.00 | 8.7 | 2.0 | 1.7 | 0.2 to 0.3 |
| right_knee_pitch | 2.85 | 6.00 | 20.1 | 13.6 | 2.3 | 0.3 to 0.5 |
| right_ankle_pitch | 3.76 | 6.00 | 46.5 | 7.2 | 2.4 | 1.2 to 1.7 |
| right_ankle_roll | 1.41 | 6.00 | 0.7 | 0.0 | 0.9 | 0.2 to 0.2 |

#### bhl_A_real_6Nm_plain: 60 s, path 8.2 m, no fall

| Joint | RMS torque (Nm) | Peak (Nm) | Time above 4 Nm (%) | Time at the limit (%) | RMS motor current (A, estimate) | Copper loss (W, estimate) |
|---|---|---|---|---|---|---|
| left_hip_roll | 2.53 | 6.00 | 19.0 | 5.5 | 2.0 | 0.3 to 0.4 |
| left_hip_yaw | 2.58 | 6.00 | 20.4 | 8.6 | 2.1 | 0.3 to 0.4 |
| left_hip_pitch | 1.74 | 6.00 | 4.5 | 0.8 | 1.4 | 0.1 to 0.2 |
| left_knee_pitch | 1.97 | 6.00 | 7.8 | 5.0 | 1.6 | 0.2 to 0.2 |
| left_ankle_pitch | 2.69 | 6.00 | 13.4 | 7.8 | 1.7 | 0.6 to 0.9 |
| left_ankle_roll | 1.68 | 6.00 | 4.6 | 0.0 | 1.1 | 0.2 to 0.3 |
| right_hip_roll | 2.45 | 6.00 | 16.5 | 1.0 | 2.0 | 0.2 to 0.4 |
| right_hip_yaw | 2.55 | 6.00 | 18.8 | 6.1 | 2.1 | 0.3 to 0.4 |
| right_hip_pitch | 1.74 | 6.00 | 5.1 | 0.9 | 1.4 | 0.1 to 0.2 |
| right_knee_pitch | 2.38 | 6.00 | 8.0 | 5.1 | 1.9 | 0.2 to 0.3 |
| right_ankle_pitch | 4.15 | 6.00 | 60.4 | 8.6 | 2.6 | 1.4 to 2.1 |
| right_ankle_roll | 1.73 | 5.71 | 4.9 | 0.0 | 1.1 | 0.2 to 0.4 |

#### bhl_B_real_6Nm_plain: 60 s, path 2.6 m, no fall

| Joint | RMS torque (Nm) | Peak (Nm) | Time above 4 Nm (%) | Time at the limit (%) | RMS motor current (A, estimate) | Copper loss (W, estimate) |
|---|---|---|---|---|---|---|
| left_hip_roll | 1.52 | 6.00 | 5.3 | 0.4 | 1.2 | 0.1 to 0.1 |
| left_hip_yaw | 1.85 | 6.00 | 7.4 | 4.9 | 1.5 | 0.1 to 0.2 |
| left_hip_pitch | 2.38 | 6.00 | 1.9 | 0.4 | 1.9 | 0.2 to 0.3 |
| left_knee_pitch | 2.21 | 6.00 | 6.4 | 3.5 | 1.8 | 0.2 to 0.3 |
| left_ankle_pitch | 1.83 | 6.00 | 4.3 | 2.2 | 1.2 | 0.3 to 0.4 |
| left_ankle_roll | 1.01 | 6.00 | 0.1 | 0.0 | 0.6 | 0.1 to 0.1 |
| right_hip_roll | 1.78 | 6.00 | 4.2 | 0.1 | 1.4 | 0.1 to 0.2 |
| right_hip_yaw | 1.86 | 6.00 | 6.7 | 3.0 | 1.5 | 0.1 to 0.2 |
| right_hip_pitch | 1.33 | 6.00 | 3.1 | 0.9 | 1.1 | 0.1 to 0.1 |
| right_knee_pitch | 1.82 | 6.00 | 5.2 | 3.3 | 1.5 | 0.1 to 0.2 |
| right_ankle_pitch | 4.41 | 6.00 | 77.1 | 2.6 | 2.8 | 1.6 to 2.4 |
| right_ankle_roll | 1.13 | 5.07 | 0.2 | 0.0 | 0.7 | 0.1 to 0.2 |

#### bhl_A_real_4Nm_kick: 2 s, path 0.7 m, falls at 4.5 s

| Joint | RMS torque (Nm) | Peak (Nm) | Time above 4 Nm (%) | Time at the limit (%) | RMS motor current (A, estimate) | Copper loss (W, estimate) |
|---|---|---|---|---|---|---|
| left_hip_roll | 2.28 | 4.00 | 0.0 | 13.8 | 1.8 | 0.2 to 0.3 |
| left_hip_yaw | 2.08 | 4.00 | 0.0 | 11.3 | 1.7 | 0.2 to 0.3 |
| left_hip_pitch | 3.47 | 4.00 | 0.0 | 68.8 | 2.8 | 0.5 to 0.7 |
| left_knee_pitch | 2.06 | 4.00 | 0.0 | 5.5 | 1.7 | 0.2 to 0.3 |
| left_ankle_pitch | 3.54 | 4.00 | 0.0 | 70.0 | 2.2 | 1.0 to 1.5 |
| left_ankle_roll | 1.97 | 4.00 | 0.0 | 3.2 | 1.2 | 0.3 to 0.5 |
| right_hip_roll | 2.01 | 4.00 | 0.0 | 19.4 | 1.6 | 0.2 to 0.2 |
| right_hip_yaw | 2.23 | 4.00 | 0.0 | 20.9 | 1.8 | 0.2 to 0.3 |
| right_hip_pitch | 1.92 | 4.00 | 0.0 | 5.7 | 1.5 | 0.1 to 0.2 |
| right_knee_pitch | 3.39 | 4.00 | 0.0 | 64.6 | 2.7 | 0.5 to 0.7 |
| right_ankle_pitch | 3.09 | 4.00 | 0.0 | 39.4 | 1.9 | 0.8 to 1.2 |
| right_ankle_roll | 1.58 | 4.00 | 0.0 | 0.5 | 1.0 | 0.2 to 0.3 |

#### Summary at 6 Nm: worse of the left and right joint

| Joint (actuator) | RMS A_real_kick (Nm) | RMS B_real_kick (Nm) | RMS A_real_plain (Nm) | RMS B_real_plain (Nm) | Above 4 Nm A_real_kick (%) | Above 4 Nm B_real_kick (%) | Above 4 Nm A_real_plain (%) | Above 4 Nm B_real_plain (%) | Highest RMS motor current (A, estimate) | Copper loss at that current, upper end (W, estimate) |
|---|---|---|---|---|---|---|---|---|---|---|
| hip_roll (6512) | 3.52 | 2.39 | 2.53 | 1.78 | 38 | 17 | 19 | 5 | 2.8 | 0.8 |
| hip_yaw (6512) | 3.60 | 3.04 | 2.58 | 1.86 | 40 | 25 | 20 | 7 | 2.9 | 0.8 |
| hip_pitch (6512) | 2.24 | 2.42 | 1.74 | 2.38 | 10 | 9 | 5 | 3 | 1.9 | 0.4 |
| knee_pitch (6512) | 2.78 | 3.03 | 2.38 | 2.21 | 17 | 21 | 8 | 6 | 2.4 | 0.6 |
| ankle_pitch (5010) | 3.26 | 3.76 | 4.15 | 4.41 | 27 | 47 | 60 | 77 | 2.8 | 2.4 |
| ankle_roll (5010) | 2.37 | 1.54 | 1.73 | 1.13 | 13 | 3 | 5 | 0 | 1.5 | 0.7 |

Runs that fall: bhl_A_real_4Nm_kick at 4.5 s, bhl_B_real_4Nm_kick at 0.9 s
