promaaa/vision-sobang/sim/sim2sim/results/results.md

| Model | Torque limit (Nm) | Command | Result in 20 s | Mean vx, 5-20 s (m/s) | Mean yaw rate, 5-20 s (rad/s) | Steps with a clipped torque (%) | Peak torque (Nm) |
|---|---|---|---|---|---|---|---|
| bhl_biped | 6 | stand | no fall | -0.00 | -0.00 | 0.2 | 6.0 |
| bhl_biped | 6 | vx 0.3 | no fall | +0.28 | -0.05 | 34.4 | 6.0 |
| bhl_biped | 6 | yaw 0.5 | no fall | -0.00 | -0.00 | 0.3 | 6.0 |
| bhl_biped | 6 | vx 0.2 + yaw 0.5 | no fall | +0.00 | -0.00 | 3.7 | 6.0 |
| bhl_biped | 4 | stand | no fall | -0.00 | -0.00 | 0.6 | 4.0 |
| bhl_biped | 4 | vx 0.3 | no fall | +0.16 | -0.02 | 99.6 | 4.0 |
| bhl_biped | 4 | yaw 0.5 | no fall | -0.00 | -0.00 | 0.8 | 4.0 |
| bhl_biped | 4 | vx 0.2 + yaw 0.5 | no fall | +0.00 | -0.00 | 98.0 | 4.0 |
| bhl_A | 6 | stand | no fall | -0.00 | -0.00 | 0.0 | 6.0 |
| bhl_A | 6 | vx 0.3 | no fall | +0.30 | -0.03 | 50.2 | 6.0 |
| bhl_A | 6 | yaw 0.5 | no fall | -0.00 | -0.00 | 0.2 | 6.0 |
| bhl_A | 6 | vx 0.2 + yaw 0.5 | no fall | +0.21 | +0.54 | 56.9 | 6.0 |
| bhl_A | 4 | stand | no fall | -0.00 | -0.00 | 0.4 | 4.0 |
| bhl_A | 4 | vx 0.3 | no fall | +0.21 | -0.09 | 99.6 | 4.0 |
| bhl_A | 4 | yaw 0.5 | no fall | -0.00 | -0.00 | 0.6 | 4.0 |
| bhl_A | 4 | vx 0.2 + yaw 0.5 | no fall | +0.15 | +0.43 | 98.0 | 4.0 |
| bhl_B | 6 | stand | no fall | -0.00 | -0.00 | 0.5 | 6.0 |
| bhl_B | 6 | vx 0.3 | no fall | +0.23 | -0.06 | 86.0 | 6.0 |
| bhl_B | 6 | yaw 0.5 | no fall | -0.00 | -0.00 | 1.0 | 6.0 |
| bhl_B | 6 | vx 0.2 + yaw 0.5 | no fall | +0.00 | -0.00 | 4.0 | 6.0 |
| bhl_B | 4 | stand | falls at 0.9 s | - | - | 93.1 | 4.0 |
| bhl_B | 4 | vx 0.3 | falls at 0.7 s | - | - | 94.6 | 4.0 |
| bhl_B | 4 | yaw 0.5 | falls at 0.9 s | - | - | 94.7 | 4.0 |
| bhl_B | 4 | vx 0.2 + yaw 0.5 | falls at 0.8 s | - | - | 94.7 | 4.0 |
| bhl_B_empty | 6 | stand | no fall | -0.00 | -0.00 | 0.1 | 6.0 |
| bhl_B_empty | 6 | vx 0.3 | no fall | +0.29 | -0.03 | 38.5 | 6.0 |
| bhl_B_empty | 6 | yaw 0.5 | no fall | -0.00 | -0.00 | 0.3 | 6.0 |
| bhl_B_empty | 6 | vx 0.2 + yaw 0.5 | no fall | +0.00 | -0.01 | 10.2 | 6.0 |
| bhl_B_empty | 4 | stand | no fall | -0.00 | -0.00 | 0.7 | 4.0 |
| bhl_B_empty | 4 | vx 0.3 | no fall | +0.14 | -0.06 | 99.2 | 4.0 |
| bhl_B_empty | 4 | yaw 0.5 | no fall | -0.00 | -0.00 | 1.0 | 4.0 |
| bhl_B_empty | 4 | vx 0.2 + yaw 0.5 | no fall | +0.07 | +0.32 | 96.1 | 4.0 |
| bhl_D | 6 | stand | no fall | -0.00 | -0.00 | 0.1 | 6.0 |
| bhl_D | 6 | vx 0.3 | no fall | +0.29 | -0.04 | 82.7 | 6.0 |
| bhl_D | 6 | yaw 0.5 | no fall | -0.00 | -0.00 | 0.2 | 6.0 |
| bhl_D | 6 | vx 0.2 + yaw 0.5 | no fall | +0.17 | +0.58 | 83.1 | 6.0 |
| bhl_D | 4 | stand | no fall | -0.00 | -0.00 | 0.5 | 4.0 |
| bhl_D | 4 | vx 0.3 | falls at 17.2 s | - | - | 99.4 | 4.0 |
| bhl_D | 4 | yaw 0.5 | no fall | -0.00 | -0.00 | 0.8 | 4.0 |
| bhl_D | 4 | vx 0.2 + yaw 0.5 | no fall | +0.09 | +0.34 | 99.6 | 4.0 |
| bhl_E | 6 | stand | no fall | -0.00 | -0.00 | 0.1 | 6.0 |
| bhl_E | 6 | vx 0.3 | no fall | -0.00 | -0.00 | 0.6 | 6.0 |
| bhl_E | 6 | yaw 0.5 | no fall | -0.00 | -0.00 | 1.1 | 6.0 |
| bhl_E | 6 | vx 0.2 + yaw 0.5 | no fall | -0.00 | -0.00 | 0.5 | 6.0 |
| bhl_E | 4 | stand | no fall | -0.00 | -0.00 | 0.6 | 4.0 |
| bhl_E | 4 | vx 0.3 | falls at 3.3 s | - | - | 96.5 | 4.0 |
| bhl_E | 4 | yaw 0.5 | no fall | -0.00 | -0.00 | 8.6 | 4.0 |
| bhl_E | 4 | vx 0.2 + yaw 0.5 | no fall | -0.00 | -0.00 | 1.4 | 4.0 |
