promaaa/vision-sobang/sim/sim2sim/results/results_keyframe.md

| Model | Torque limit (Nm) | Command | Result in 20 s | Mean vx, 5-20 s (m/s) | Mean yaw rate, 5-20 s (rad/s) | Steps with a clipped torque (%) | Peak torque (Nm) |
|---|---|---|---|---|---|---|---|
| bhl_biped | 6 | stand | no fall | -0.00 | +0.00 | 0.1 | 6.0 |
| bhl_biped | 6 | vx 0.3 | no fall | +0.00 | -0.00 | 0.0 | 6.0 |
| bhl_biped | 6 | yaw 0.5 | no fall | +0.00 | +0.00 | 0.1 | 6.0 |
| bhl_biped | 6 | vx 0.2 + yaw 0.5 | no fall | +0.00 | -0.00 | 0.0 | 6.0 |
| bhl_biped | 4 | stand | no fall | -0.00 | +0.00 | 0.3 | 4.0 |
| bhl_biped | 4 | vx 0.3 | no fall | +0.16 | -0.03 | 99.2 | 4.0 |
| bhl_biped | 4 | yaw 0.5 | no fall | +0.00 | +0.00 | 0.3 | 4.0 |
| bhl_biped | 4 | vx 0.2 + yaw 0.5 | no fall | +0.00 | -0.00 | 99.0 | 4.0 |
| bhl_A | 6 | stand | no fall | -0.00 | +0.00 | 0.2 | 6.0 |
| bhl_A | 6 | vx 0.3 | no fall | +0.30 | -0.02 | 47.4 | 6.0 |
| bhl_A | 6 | yaw 0.5 | no fall | +0.00 | +0.00 | 0.2 | 6.0 |
| bhl_A | 6 | vx 0.2 + yaw 0.5 | no fall | +0.00 | -0.00 | 0.0 | 6.0 |
| bhl_A | 4 | stand | no fall | -0.00 | +0.00 | 0.6 | 4.0 |
| bhl_A | 4 | vx 0.3 | no fall | +0.21 | -0.09 | 99.2 | 4.0 |
| bhl_A | 4 | yaw 0.5 | no fall | +0.00 | +0.00 | 0.8 | 4.0 |
| bhl_A | 4 | vx 0.2 + yaw 0.5 | no fall | +0.15 | +0.42 | 99.4 | 4.0 |
| bhl_B | 6 | stand | no fall | -0.00 | +0.00 | 0.1 | 6.0 |
| bhl_B | 6 | vx 0.3 | no fall | +0.23 | -0.06 | 82.8 | 6.0 |
| bhl_B | 6 | yaw 0.5 | no fall | +0.00 | +0.00 | 0.2 | 6.0 |
| bhl_B | 6 | vx 0.2 + yaw 0.5 | no fall | +0.00 | -0.00 | 0.0 | 6.0 |
| bhl_B | 4 | stand | no fall | -0.00 | +0.00 | 0.4 | 4.0 |
| bhl_B | 4 | vx 0.3 | falls at 2.1 s | - | - | 90.5 | 4.0 |
| bhl_B | 4 | yaw 0.5 | no fall | +0.00 | +0.00 | 0.4 | 4.0 |
| bhl_B | 4 | vx 0.2 + yaw 0.5 | falls at 3.0 s | - | - | 88.2 | 4.0 |
| bhl_B_empty | 6 | stand | no fall | -0.00 | +0.00 | 0.1 | 6.0 |
| bhl_B_empty | 6 | vx 0.3 | no fall | +0.00 | -0.00 | 1.1 | 6.0 |
| bhl_B_empty | 6 | yaw 0.5 | no fall | +0.00 | +0.00 | 0.1 | 6.0 |
| bhl_B_empty | 6 | vx 0.2 + yaw 0.5 | no fall | +0.00 | -0.00 | 0.0 | 6.0 |
| bhl_B_empty | 4 | stand | no fall | -0.00 | +0.00 | 0.4 | 4.0 |
| bhl_B_empty | 4 | vx 0.3 | no fall | +0.15 | -0.05 | 99.2 | 4.0 |
| bhl_B_empty | 4 | yaw 0.5 | no fall | +0.00 | +0.00 | 0.4 | 4.0 |
| bhl_B_empty | 4 | vx 0.2 + yaw 0.5 | falls at 3.6 s | - | - | 94.5 | 4.0 |
| bhl_D | 6 | stand | no fall | -0.00 | +0.00 | 0.2 | 6.0 |
| bhl_D | 6 | vx 0.3 | no fall | +0.29 | -0.04 | 82.2 | 6.0 |
| bhl_D | 6 | yaw 0.5 | no fall | +0.00 | +0.00 | 0.2 | 6.0 |
| bhl_D | 6 | vx 0.2 + yaw 0.5 | no fall | +0.00 | -0.00 | 2.5 | 6.0 |
| bhl_D | 4 | stand | no fall | -0.00 | +0.00 | 0.4 | 4.0 |
| bhl_D | 4 | vx 0.3 | no fall | +0.14 | +0.02 | 98.4 | 4.0 |
| bhl_D | 4 | yaw 0.5 | no fall | +0.00 | +0.00 | 0.5 | 4.0 |
| bhl_D | 4 | vx 0.2 + yaw 0.5 | falls at 2.7 s | - | - | 95.6 | 4.0 |
| bhl_E | 6 | stand | no fall | -0.00 | +0.00 | 0.1 | 6.0 |
| bhl_E | 6 | vx 0.3 | no fall | -0.00 | -0.00 | 0.0 | 6.0 |
| bhl_E | 6 | yaw 0.5 | no fall | -0.00 | +0.00 | 0.1 | 6.0 |
| bhl_E | 6 | vx 0.2 + yaw 0.5 | no fall | -0.00 | -0.00 | 0.0 | 6.0 |
| bhl_E | 4 | stand | no fall | -0.00 | +0.00 | 0.4 | 4.0 |
| bhl_E | 4 | vx 0.3 | no fall | -0.00 | -0.00 | 0.2 | 4.0 |
| bhl_E | 4 | yaw 0.5 | no fall | -0.00 | +0.00 | 0.4 | 4.0 |
| bhl_E | 4 | vx 0.2 + yaw 0.5 | no fall | -0.00 | -0.00 | 0.2 | 4.0 |
