promaaa/vision-sobang/sim/sim2sim/results/results_noise.md

| Model | Torque limit (Nm) | Command | Result in 20 s | Mean vx, 5-20 s (m/s) | Mean yaw rate, 5-20 s (rad/s) | Steps with a clipped torque (%) | Peak torque (Nm) |
|---|---|---|---|---|---|---|---|
| bhl_biped | 6 | stand | no fall | +0.00 | -0.00 | 0.2 | 6.0 |
| bhl_biped | 6 | vx 0.3 | no fall | +0.29 | -0.04 | 48.0 | 6.0 |
| bhl_biped | 6 | yaw 0.5 | no fall | +0.00 | +0.04 | 4.9 | 6.0 |
| bhl_biped | 6 | vx 0.2 + yaw 0.5 | no fall | +0.19 | +0.50 | 45.4 | 6.0 |
| bhl_biped | 4 | stand | no fall | +0.00 | -0.00 | 1.5 | 4.0 |
| bhl_biped | 4 | vx 0.3 | no fall | +0.17 | -0.02 | 99.6 | 4.0 |
| bhl_biped | 4 | yaw 0.5 | no fall | +0.00 | +0.03 | 13.2 | 4.0 |
| bhl_biped | 4 | vx 0.2 + yaw 0.5 | no fall | +0.09 | +0.38 | 96.2 | 4.0 |
| bhl_A | 6 | stand | no fall | +0.00 | -0.00 | 0.1 | 6.0 |
| bhl_A | 6 | vx 0.3 | no fall | +0.30 | -0.03 | 67.6 | 6.0 |
| bhl_A | 6 | yaw 0.5 | no fall | +0.00 | +0.03 | 5.2 | 6.0 |
| bhl_A | 6 | vx 0.2 + yaw 0.5 | no fall | +0.20 | +0.53 | 67.2 | 6.0 |
| bhl_A | 4 | stand | no fall | +0.00 | -0.00 | 1.7 | 4.0 |
| bhl_A | 4 | vx 0.3 | no fall | +0.22 | -0.03 | 99.1 | 4.0 |
| bhl_A | 4 | yaw 0.5 | no fall | -0.00 | +0.06 | 40.0 | 4.0 |
| bhl_A | 4 | vx 0.2 + yaw 0.5 | falls at 4.9 s | - | - | 96.8 | 4.0 |
| bhl_B | 6 | stand | no fall | +0.00 | -0.00 | 1.0 | 6.0 |
| bhl_B | 6 | vx 0.3 | no fall | +0.16 | -0.05 | 84.6 | 6.0 |
| bhl_B | 6 | yaw 0.5 | no fall | +0.00 | +0.01 | 8.8 | 6.0 |
| bhl_B | 6 | vx 0.2 + yaw 0.5 | no fall | +0.07 | +0.29 | 51.2 | 6.0 |
| bhl_B | 4 | stand | falls at 0.9 s | - | - | 90.9 | 4.0 |
| bhl_B | 4 | vx 0.3 | falls at 0.8 s | - | - | 95.5 | 4.0 |
| bhl_B | 4 | yaw 0.5 | falls at 0.9 s | - | - | 92.7 | 4.0 |
| bhl_B | 4 | vx 0.2 + yaw 0.5 | falls at 0.8 s | - | - | 95.2 | 4.0 |
| bhl_B_empty | 6 | stand | no fall | +0.00 | -0.00 | 0.2 | 6.0 |
| bhl_B_empty | 6 | vx 0.3 | no fall | +0.28 | -0.04 | 64.0 | 6.0 |
| bhl_B_empty | 6 | yaw 0.5 | no fall | +0.00 | +0.03 | 3.3 | 6.0 |
| bhl_B_empty | 6 | vx 0.2 + yaw 0.5 | no fall | +0.16 | +0.50 | 54.0 | 6.0 |
| bhl_B_empty | 4 | stand | no fall | +0.00 | -0.00 | 1.8 | 4.0 |
| bhl_B_empty | 4 | vx 0.3 | falls at 17.1 s | - | - | 98.1 | 4.0 |
| bhl_B_empty | 4 | yaw 0.5 | no fall | +0.00 | +0.02 | 15.0 | 4.0 |
| bhl_B_empty | 4 | vx 0.2 + yaw 0.5 | falls at 14.0 s | - | - | 94.6 | 4.0 |
| bhl_D | 6 | stand | no fall | +0.00 | -0.00 | 0.2 | 6.0 |
| bhl_D | 6 | vx 0.3 | no fall | +0.28 | -0.03 | 79.4 | 6.0 |
| bhl_D | 6 | yaw 0.5 | no fall | +0.00 | +0.01 | 3.8 | 6.0 |
| bhl_D | 6 | vx 0.2 + yaw 0.5 | no fall | +0.18 | +0.54 | 84.3 | 6.0 |
| bhl_D | 4 | stand | no fall | +0.00 | -0.00 | 2.8 | 4.0 |
| bhl_D | 4 | vx 0.3 | falls at 5.2 s | - | - | 99.4 | 4.0 |
| bhl_D | 4 | yaw 0.5 | no fall | +0.00 | +0.01 | 13.6 | 4.0 |
| bhl_D | 4 | vx 0.2 + yaw 0.5 | falls at 4.7 s | - | - | 98.6 | 4.0 |
| bhl_E | 6 | stand | no fall | -0.00 | +0.00 | 0.2 | 6.0 |
| bhl_E | 6 | vx 0.3 | no fall | +0.21 | -0.05 | 62.6 | 6.0 |
| bhl_E | 6 | yaw 0.5 | no fall | +0.00 | +0.01 | 9.4 | 6.0 |
| bhl_E | 6 | vx 0.2 + yaw 0.5 | no fall | +0.21 | +0.49 | 63.7 | 6.0 |
| bhl_E | 4 | stand | no fall | -0.00 | +0.00 | 5.9 | 4.0 |
| bhl_E | 4 | vx 0.3 | no fall | +0.06 | -0.00 | 88.1 | 4.0 |
| bhl_E | 4 | yaw 0.5 | falls at 1.5 s | - | - | 95.2 | 4.0 |
| bhl_E | 4 | vx 0.2 + yaw 0.5 | falls at 13.1 s | - | - | 99.3 | 4.0 |
