promaaa/vision-sobang/sim/sim2sim/results/demo_log.csv

t | x | y | yaw | state | vx_cmd | yaw_rate_cmd | pan | tilt | pump_on | fire_health | dist
0.0 | 0.0 | 0.0 | 0.0 | SEARCH | 0.2 | 0.4 | 0.0 | -0.10471975511965978 | False | 1.0 | 2.9154759474226504
0.1 | 0.022568678825555112 | -0.011056989364546474 | -0.007680984482282416 | SEARCH | 0.2 | 0.4 | 0.0 | -0.10471975511965978 | False | 1.0 | 2.9018888979841395
0.2 | 0.023835220545030365 | -0.004080570290028002 | -0.00033175261595204115 | SEARCH | 0.2 | 0.4 | 0.0 | -0.10471975511965978 | False | 1.0 | 2.897179728104084
0.3 | 0.012513678004884435 | 0.00608641767855989 | 0.04437609090395119 | APPROACH | 0.2 | 0.6 | 0.30000000000000004 | -0.01701826245251431 | False | 1.0 | 2.9016143771282334
0.4 | 0.030771880407383167 | -0.004564218020896894 | 0.05922437483447626 | APPROACH | 0.2 | 0.6 | 0.48752799126215185 | -0.01960724895556154 | False | 1.0 | 2.891504970207681
0.5 | 0.030042658892737842 | -0.016740450303198907 | 0.0983064528689134 | APPROACH | 0.2 | 0.6 | 0.45225204290800786 | -0.01815207057919227 | False | 1.0 | 2.8984807849070875
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
