promaaa/vision-sobang/sim/sim2sim/results/demo_real_log.csv

t | x | y | yaw | state | vx_cmd | yaw_rate_cmd | pan | tilt | pump_on | fire_health | dist
0.0 | 0.0 | 0.0 | 0.0 | SEARCH | 0.25 | 0.4 | 0.0 | -0.10471975511965978 | False | 1.0 | 2.5
0.1 | 0.0223625907972085 | -0.010114221263755361 | -0.005729685348876977 | SEARCH | 0.25 | 0.4 | 0.0 | -0.10471975511965978 | False | 1.0 | 2.5119136295534736
0.2 | 0.03307406426708493 | -0.004295634436295943 | -0.0034529441485730283 | SEARCH | 0.25 | 0.4 | 0.0 | -0.10471975511965978 | False | 1.0 | 2.5239892432341717
0.3 | 0.015876518337472577 | 0.00783933959792355 | 0.05318174230286223 | SEARCH | 0.25 | 0.4 | 0.0 | -0.10471975511965978 | False | 1.0 | 2.5174069220575985
0.4 | 0.030629800322119642 | -0.0016303412966319293 | 0.08004543586917516 | SEARCH | 0.25 | 0.4 | 0.0 | -0.10471975511965978 | False | 1.0 | 2.5236023894581927
0.5 | 0.03701559014379452 | -0.010249664597635436 | 0.0769197060673006 | SEARCH | 0.25 | 0.4 | 0.0 | -0.10471975511965978 | False | 1.0 | 2.5236458896446483
0.6 | 0.04981881037428094 | -0.01994048361146423 | 0.1176785534882658 | SEARCH | 0.25 | 0.4 | 0.0 | -0.10471975511965978 | False | 1.0 | 2.5283064148588674
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
