promaaa/vision-sobang/sim/sim2sim/results/sil_ahead_1_log.csv

t | state | x | y | yaw | roll | pitch | vx_cmd | yaw_rate_cmd | pan_cmd | tilt_cmd | pan | tilt | pump_on | detections | labels | land_x | land_y | land_err | health_fire0
0.0 | SEARCH | 0.0 | 0.0 | 0.0 | 0.0 | -0.0 | 0.25 | 0.4 | 0.0 | -0.105 | 0.0 | -0.0 | False | 2 | lamp fire0 |  |  |  | 1.0
0.1 | SEARCH | 0.024 | -0.009 | -0.006 | -0.011 | -0.036 | 0.25 | 0.4 | 0.0 | -0.105 | -0.0 | -0.076 | False | 2 | lamp fire0 |  |  |  | 1.0
0.2 | SEARCH | 0.034 | -0.005 | -0.005 | 0.009 | -0.046 | 0.25 | 0.4 | 0.0 | -0.105 | -0.002 | -0.066 | False | 2 | lamp fire0 |  |  |  | 1.0
0.3 | SEARCH | 0.018 | 0.008 | 0.051 | 0.029 | -0.0 | 0.25 | 0.4 | 0.0 | -0.105 | 0.001 | -0.097 | False | 2 | lamp fire0 |  |  |  | 1.0
0.4 | APPROACH | 0.031 | -0.003 | 0.081 | 0.004 | 0.01 | 0.25 | -0.11578823906562535 | -0.063 | -0.072 | 0.003 | -0.102 | False | 2 | lamp fire0 |  |  |  | 1.0
0.5 | APPROACH | 0.037 | -0.01 | 0.039 | -0.005 | 0.031 | 0.25 | -0.07943693698399643 | -0.053 | -0.066 | -0.049 | -0.073 | False | 2 | lamp fire0 |  |  |  | 1.0
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
