promaaa/vision-sobang/sim/sim2sim/results/demo.png

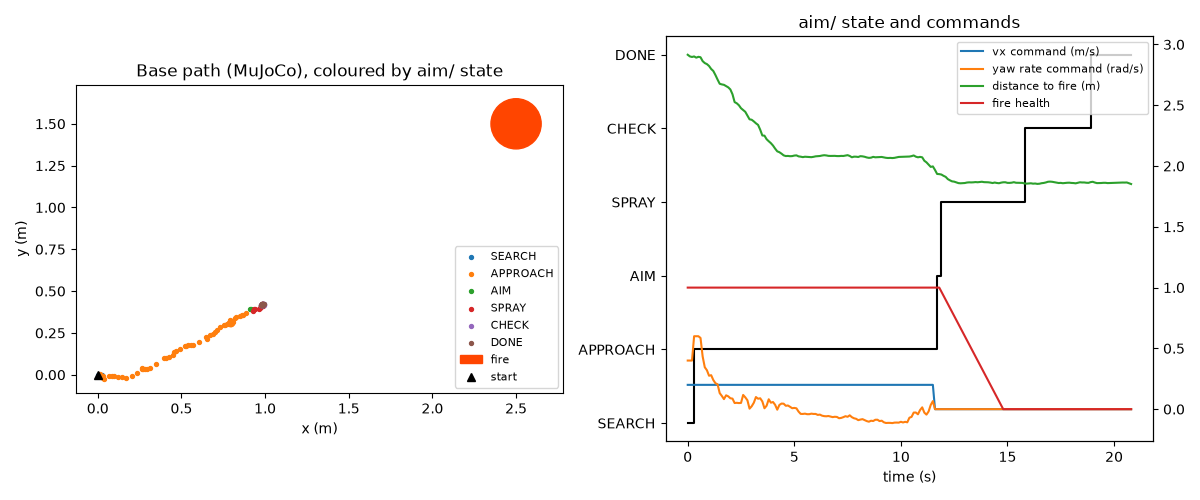
sim/sim2sim/results/demo.png
