promaaa/vision-sobang/sim/sim2sim/results/demo_real.png

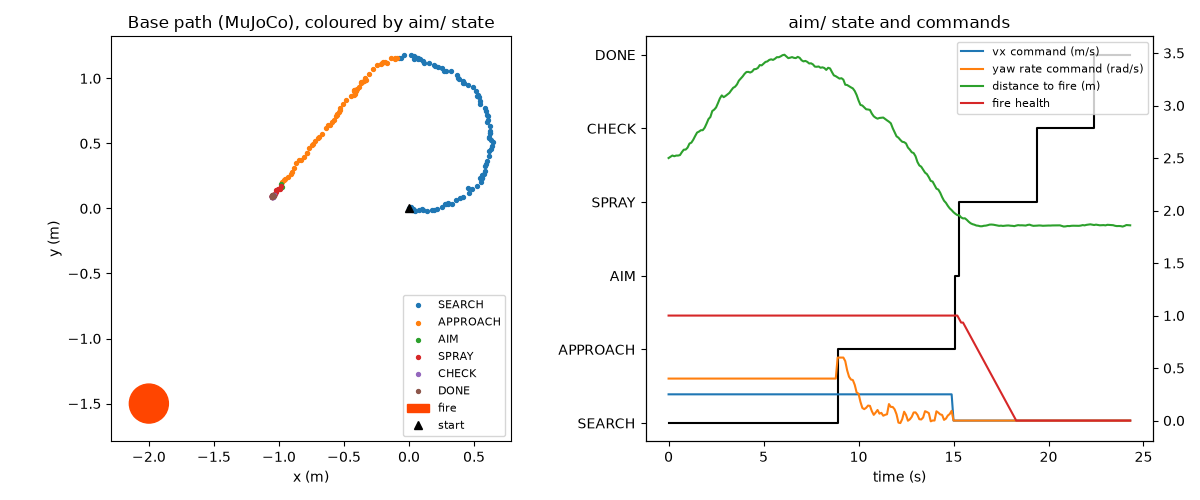
sim/sim2sim/results/demo_real.png
