promaaa/vision-sobang/(commit log)

2026-10-11 Add a shared uv environment for the code and the simulations
    One Python 3.12 environment at the repository root (uv sync) runs the
    aiming code, the actuator drivers and the MuJoCo simulations.
    uv run pytest runs the tests of aim/ and actuators/.
    scripts/fetch_bhl_assets.sh downloads the Berkeley assets at a fixed commit.
2026-10-11 Add the body concepts, printable parts and bench rig
    Blender scripts and renders of concepts A to E, the pan-tilt module for
    concept A (DS3218 and ST3215 versions), adapters for B and E, the splash
    guard and backpack, the bench rig, camera views and turntable videos.
    cad/pyproject.toml is the build123d environment for the parts.
    [base_clamp.step, base_clamp.stl, base_tripod.step, base_tripod.stl, bracket_lower.step, bracket_lower.stl, bracket_upper.step, bracket_upper.stl]
2026-10-11 Add the payload, walking-policy, aiming-loop and fire-scene simulations
    sim/payload: MuJoCo models with each payload, torques and push tests.
    sim/sim2sim: the official Berkeley policy with our payloads, the closed
    loop, the camera-in-the-loop scenarios and the software-in-the-loop test.
    Outputs go to sim/sim2sim/results/.
    sim/rl: policy training with MuJoCo Playground (own uv project, GPU).
    sim/firescenes: synthetic RGB and thermal-like fire images.
    [demo_log.csv, demo_real_log.csv, sil_ahead_1_log.csv, sil_ahead_2_log.csv, sil_ahead_3_log.csv, sil_two_fires_1_log.csv, sil_two_fires_2_log.csv, sil_two_fires_3_log.csv]
2026-10-11 Add the aiming code and the actuator drivers
    aim/: fire position, jet solver, spray state machine and UDP runtime.
    actuators/: ST3215 servo driver, Pico relay firmware, actuator node,
    walk bridge and first-day self-test, all with a mock mode.
2026-10-11 Add the hardware, locomotion and architecture notes and the website sources
    docs/hardware: parts list with links, wiring and research notes.
    docs/locomotion: how the Berkeley team trains and deploys its policy.
    docs/site: the sources of the website in the gh-pages branch.
    [bom_A.csv, bom_B.csv, bom_E.csv, bom_extinction.csv]
2026-10-13 Add the torso pump study: tanks R1 and R2, CAD, simulation round 5 and the site page
    cad/torso_tank: printable tanks R1 (inside the torso) and R2 (on the sides), STEP and STL files, checks and renders.
    sim/payload/torso_tank.py: statics, walking, push test, slosh and jet for R1 and R2, with models and results.
    docs/site: the Torso pump page and its nav links, status row and decision D6.
    [r1_deck.step, r1_deck.stl, r1_half_left.step, r1_half_left.stl, r1_half_right.step, r1_half_right.stl, r1_tank.step, r1_tank.stl]
